newaetech/phywhispererusb/firmware/README.md

# Firmware for SAM3U #

This directory includes the firmware for the SAM3U used as part of the USB interface.

To build, run `make` in `phywhisperer` subdirectory of this firmware directory. You will need the gcc-arm-none-eabi installed for your system (Linux, Windows, etc).
