newaetech/phywhispererusb/hardware/doc/phywhisperer_00.jpg

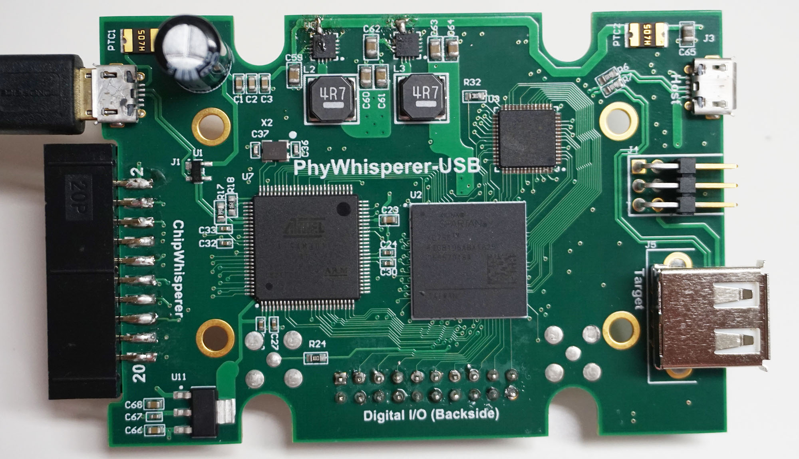
hardware/doc/phywhisperer_00.jpg
