newaetech/phywhispererusb/hardware/doc/phywhisperer_03_back.jpg

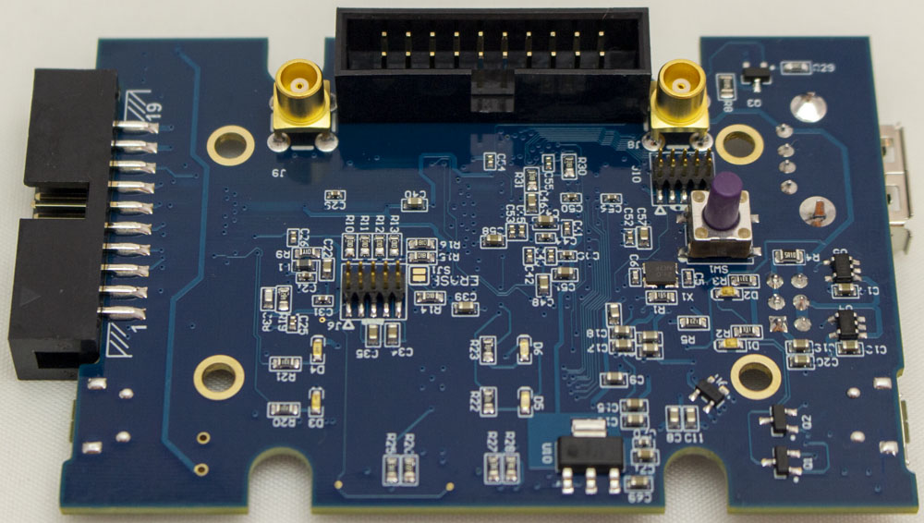
hardware/doc/phywhisperer_03_back.jpg
