newaetech/phywhispererusb/hardware/doc/phywhispererpcb.png

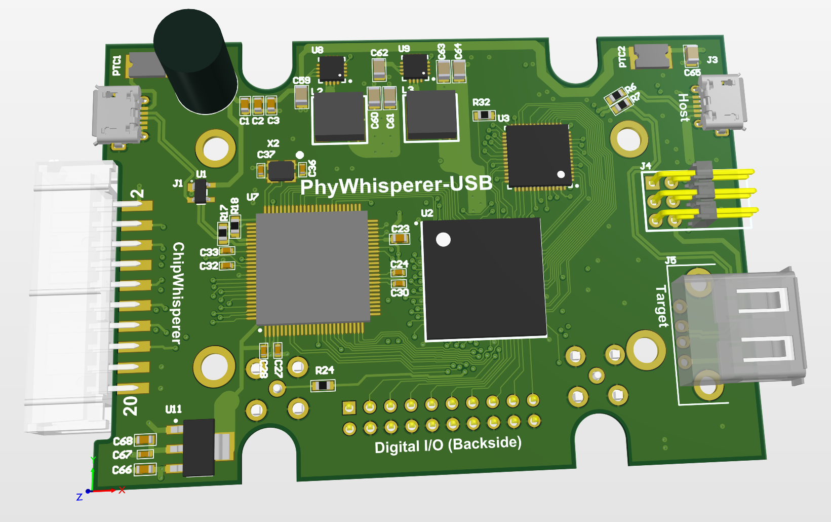
hardware/doc/phywhispererpcb.png
