newaetech/phywhispererusb/hardware/altium_source/altium_fpga_pins.csv

# Altium Pin Report File
Pin Designator | Net Name | Display Name | IO Bank | IO Standard | Slew Rate | Drive Strength | IO Pin | Vref Pin | CLK Pin | Config Pin | Special Pin | Group | Differential Pair
A1 | GND | GND
A2 | LED_CAP | IO_L3N_T0_DQS_34
A3 | USB_NCS | IO_L2N_T0_34
A4 | USB_SPARE1 | IO_L2P_T0_34
A5 | USB_D1 | IO_L4N_T0_34
A6 | GND | GND
A7 | FPGA_TCK | TCK_0
A8 | FPGA_CCLK | CCLK_0
A9 | GND | GND
A10 | F_USB21 | IO_L3N_T0_DQS_EMCCLK_14
A11 | GND | GND
A12 | F_USB29 | IO_L4P_T0_D04_14
A13 | F_USB31 | IO_L4N_T0_D05_14
A14 | GND | GND
B1 | FPGA_CWIO11 | IO_L5N_T0_34
B2 | USB_NWE | IO_L5P_T0_34
B3 | USB_NRD | IO_L3P_T0_DQS_34
B4 | GND | GND
B5 | USB_D5 | IO_L4P_T0_34
B6 | USB_D0 | IO_0_34
B7 | GND | GND
B8 |  | NC
B9 | GND | GND
B10 | F_USB22 | IO_L3P_T0_DQS_PUDC_B_14
B11 | F_USB28 | IO_L1P_T0_D00_MOSI_14
B12 | FPGA_CDOUT | IO_L1N_T0_D01_DIN_14
B13 | F_USB32 | IO_L5P_T0_D06_14
B14 | F_USB0 | IO_L5N_T0_D07_14
C1 | FPGA_CWIO5 | IO_L11N_T1_SRCC_34
C2 | GND | GND
C3 |  | IO_L1N_T0_34
C4 |  | IO_L6N_T0_VREF_34
C5 |  | IO_L6P_T0_34
C6 | GND | GND
C7 | GND | GND
C8 | GND | GND
C9 | GND | GND
C10 | F_USB23 | IO_L2N_T0_D03_14
C11 | F_USB25 | IO_L6P_T0_FCS_B_14
C12 | F_USB30 | IO_L6N_T0_D08_VREF_14
C13 | GND | GND
C14 | F_USB2 | IO_L11N_T1_SRCC_14
D1 | USB_CLK | IO_L11P_T1_SRCC_34
D2 | LED_TRIG | IO_L10N_T1_34
D3 |  | IO_L1P_T0_34
D4 |  | IO_L7N_T1_34
D5 | GND | GND
D6 | VCCINT | VCCINT
D7 | GND | GND
D8 | VCCINT | VCCINT
D9 | GND | GND
D10 | F_USB24 | IO_L2P_T0_D02_14
D11 | GND | GND
D12 |  | IO_L8P_T1_D11_14
D13 | F_USB3 | IO_L8N_T1_D12_14
D14 | F_USB4 | IO_L11P_T1_SRCC_14
E1 | GND | GND
E2 | FPGA_CWIO10 | IO_L10P_T1_34
E3 | GND | GND
E4 |  | IO_L7P_T1_34
E5 | VCCINT | VCCBRAM
E6 | GND | GND
E7 | VCCINT | VCCINT
E8 | GND | GND
E9 | VCCINT | VCCINT
E10 | GND | GND
E11 | F_USB26 | IO_0_14
E12 |  | IO_L7N_T1_D10_14
E13 | F_USB5 | IO_L10N_T1_D15_14
E14 | GND | GND
F1 | FPGA_CWIO4 | IO_L9N_T1_DQS_34
F2 | FPGA_CWIO9 | IO_L8N_T1_34
F3 | FPGA_CWIO3 | IO_L8P_T1_34
F4 |  | IO_L12N_T1_MRCC_34
F5 | GND | GND
F6 | VCCINT | VCCINT
F7 |  | NC
F8 |  | NC
F9 | GND | GND
F10 | VCC1V8 | VCCAUX
F11 | F_USB27 | IO_L12N_T1_MRCC_14
F12 |  | IO_L7P_T1_D09_14
F13 | F_USB6 | IO_L10P_T1_D14_14
F14 | F_USB1 | IO_L9N_T1_DQS_D13_14
G1 | USB_A2 | IO_L9P_T1_DQS_34
G2 | VCCIO | VCCO_34
G3 | GND | GND
G4 |  | IO_L12P_T1_MRCC_34
G5 | VCCINT | VCCBRAM
G6 | GND | GND
G7 |  | NC
G8 |  | NC
G9 | VCCINT | VCCINT
G10 | GND | GND
G11 | USERIO_CLK | IO_L12P_T1_MRCC_14
G12 | GND | GND
G13 | VCCIO | VCCO_14
G14 | F_USB7 | IO_L9P_T1_DQS_14
H1 | USB_A3 | IO_L14N_T2_SRCC_34
H2 | USB_A4 | IO_L14P_T2_SRCC_34
H3 | USB_D2 | IO_L13N_T2_MRCC_34
H4 |  | IO_L13P_T2_MRCC_34
H5 | GND | GND
H6 | VCCINT | VCCINT
H7 |  | NC
H8 |  | NC
H9 | GND | GND
H10 | VCC1V8 | VCCAUX
H11 |  | IO_L13P_T2_MRCC_14
H12 |  | IO_L13N_T2_MRCC_14
H13 | F_USBFE_CLK | IO_L14P_T2_SRCC_14
H14 | F_USB8 | IO_L14N_T2_SRCC_14
J1 | USB_D3 | IO_L15N_T2_DQS_34
J2 | USB_D4 | IO_L15P_T2_DQS_34
J3 | USB_A7 | IO_L17N_T2_34
J4 |  | IO_L17P_T2_34
J5 | VCCINT | VCCBRAM
J6 | GND | GND
J7 |  | DXN_0
J8 |  | DXP_0
J9 | VCCINT | VCCINT
J10 | GND | GND
J11 |  | IO_L17P_T2_D30_14
J12 | F_USB15 | IO_L17N_T2_D29_14
J13 | F_USB10 | IO_L18P_T2_D28_14
J14 | F_USB9 | IO_L18N_T2_D27_14
K1 | GND | GND
K2 | VCCIO | VCCO_34
K3 | USB_SPARE0 | IO_L16N_T2_34
K4 | F_VBDC | IO_L16P_T2_34
K5 | GND | GND
K6 | VCCINT | VCCINT
K7 | GND | GND
K8 | VCCINT | VCCINT
K9 | GND | GND
K10 | VCC1V8 | VCCAUX
K11 | F_USB17 | IO_L19P_T3_D26_14
K12 | F_USB16 | IO_L19N_T3_D25_VREF_14
K13 | VCCIO | VCCO_14
K14 | GND | GND
L1 | USB_A0 | IO_L18N_T2_34
L2 | USB_A1 | IO_L22N_T3_34
L3 | FPGA_CWIO2 | IO_L22P_T3_34
L4 | GND | GND
L5 |  | IO_25_34
L6 | GND | GND
L7 | FPGA_PGMB | PROGRAM_B_0
L8 | GND | GND
L9 | VCC1V8 | VCCAUX
L10 | GND | GND
L11 | GND | GND
L12 | F_USB20 | IO_L16P_T2_CSI_B_14
L13 | F_USB11 | IO_L16N_T2_D31_14
L14 | F_USB12 | IO_L15N_T2_DQS_DOUT_CSO_B_14
M1 | FPGA_CWIO8 | IO_L18P_T2_34
M2 | FPGA_CWIO1 | IO_L19N_T3_VREF_34
M3 | FPGA_CWIO0 | IO_L19P_T3_34
M4 |  | IO_L23N_T3_34
M5 |  | IO_L23P_T3_34
M6 | FPGA_TMS | TMS_0
M7 | VCCIO | M0_0
M8 | VCCIO | M1_0
M9 | VCCIO | M2_0
M10 | USERIO_D7 | IO_25_14
M11 | F_USB19 | IO_L20P_T3_D24_14
M12 | USERIO_D2 | IO_L20N_T3_D23_14
M13 | FPGA_TRIGOUT | IO_L15P_T2_DQS_RDWR_B_14
M14 | F_USB14 | IO_L21N_T3_DQS_D22_14
N1 | FPGA_CWIO7 | IO_L20N_T3_34
N2 | VCCIO | VCCO_34
N3 | GND | GND
N4 | USB_D7 | IO_L24N_T3_34
N5 | GND | GND
N6 | VCCIO | VCCO_0
N7 | VCCIO | CFGBVS_0
N8 | VCCIO | VCCO_0
N9 | GND | GND
N10 | USERIO_D6 | IO_L23P_T3_D19_14
N11 | USERIO_D4 | IO_L23N_T3_D18_14
N12 | GND | GND
N13 | VCCIO | VCCO_14
N14 | F_USB13 | IO_L21P_T3_DQS_14
P1 | GND | GND
P2 | FPGA_CWIO6 | IO_L20P_T3_34
P3 | USB_A5 | IO_L21N_T3_DQS_34
P4 | USB_A6 | IO_L21P_T3_DQS_34
P5 | USB_D6 | IO_L24P_T3_34
P6 | FPGA_TDO | TDO_0
P7 | FPGA_TDI | TDI_0
P8 | FPGA_INITB | INIT_B_0
P9 | FPGA_DONE | DONE_0
P10 | USERIO_D5 | IO_L24P_T3_D17_14
P11 | USERIO_D3 | IO_L24N_T3_D16_14
P12 | USERIO_D1 | IO_L22P_T3_D21_14
P13 | USERIO_D0 | IO_L22N_T3_D20_14
P14 | GND | GND
