newaetech/phywhispererusb/docs/getting-started.rst

.. _getting_started:

########
Overview
########

Todo
