newaetech/phywhispererusb/(threads)

Thread 1 (2019-07-25):

Firmware - Change usb PID

colinoflynn, 2019-07-25:
Actual PID is 0xC610 to be used in future. Will build Windows signed drivers for that as well, once drivers available can switch firmware+python code.

colinoflynn, 2019-11-12:
Fixed in recent commit.

Closed 2019-11-12.

Thread 3 (2020-01-09):

Trigger do not work on custom database descriptor packets

h0rac, 2020-01-09:
Hi

I have following issue with phywhisperer, I am not able to trigger on `dev.ctrl_transfer(bmRequestType=0x80, bRequest=0x06, wValue=0x0001, wIndex=0x0000, data_or_wLength=0x1F, timeout=5)`

My trigger is set to   ` phy.set_pattern(pattern=[0x80, 0x06, 0x00, 0x01, 0x00, 0x00, 0x1F])`

I can trigger on any original packets received on USB bus by phywisperer but not on packets I want to inject using pyusb

When I inject packet I can see it with logic analyser Saleae, but cannot trigger on it using phywisperer

My physical setup: HOST/CONTROL PC connected to OS X, TARGET to USB key

```
try:
    phy = pw.Usb()
    phy.con(program_fpga=True)
    print(phy.get_fpga_buildtime())
    phy.load_bitstream("phywhisperer_top.bit")
    phy.set_usb_mode('auto')
    phy.set_pattern(pattern=[0x80, 0x06, 0x00, 0x01, 0x00, 0x00, 0x1F])
    phy.set_capture_size(8000)
    while True:
        phy.set_power_source("host")
        # time.sleep(0.5)
        dev = usb.core.find(idVendor=2414, idProduct=2132)
        dev.set_configuration()
        if dev is None:
            raise ValueError('Our device is not connected')
        # print("USB Dev:", dev)
        phy.set_trigger(num_triggers=1, delays=[453], widths=[80], enable=True)
        phy.arm()
        dev.ctrl_transfer(bmRequestType=0x80, bRequest=0x06, wValue=0x0001, wIndex=0x0000, data_or_wLength=0x1F, timeout=15)
        time.sleep(0.5)
        phy.set_power_source("off")
        time.sleep(0.1)
        # arm:
        phy.set_power_source("host")
        time.sleep(0.1)
        # phy.wait_disarmed()
        print("done")
        phy.addpattern = True
.....
```

jpcrypt, 2020-01-09:
What does `phy.get_usb_mode()` return? (if it's "auto" then the target speed hasn't been detected properly, which means that the phy won't be programmed correctly).

It's also possible that things get out of whack because you're possibly re-arming PW in the while loop without having captured anything. If you must have a while loop around the PW arming, you should call `reset_fpga()` before re-arming (you'll also need to re-program all PW parameters).

Finally I would try relaxing the match pattern to see what PW *is* seeing.

h0rac, 2020-01-09:
Hi thanks for answer

`phy.get_usb_mode() ` return auto and then FS if I check in loop. When I set it to FS manually it triggers but only for short pattern like [0x00, 0x1F] entire packet trigger is not working.

jpcrypt, 2020-01-09:
Can you try the following:
```
phy = pw.Usb()
phy.con(program_fpga=True)
print(phy.get_fpga_buildtime())
phy.reset_fpga()
phy.set_usb_mode('FS')
#phy.set_pattern(pattern=[0x80, 0x06, 0x00, 0x01, 0x00, 0x00, 0x1F])
phy.set_pattern(pattern=[0x80, 0x06])
phy.set_capture_size(8000)

phy.set_power_source("host")
# time.sleep(0.5)
dev = usb.core.find(idVendor=2414, idProduct=2132)
dev.set_configuration()
if dev is None:
    raise ValueError('Our device is not connected')

phy.arm()
# make sure we haven't seen a match yet:
assert phy.armed() == True

dev.ctrl_transfer(bmRequestType=0x80, bRequest=0x06, wValue=0x0001, wIndex=0x0000, data_or_wLength=0x1F, timeout=15)
phy.wait_disarmed()
print("done")
phy.addpattern = True
raw = phy.read_capture_data()
...
```

Assuming this runs through, look for your pattern in `raw`.

h0rac, 2020-01-09:
it do not trigger, but this one works.. up to [0x00,0x00,0xFF,0xFF]

```
try:
    phy = pw.Usb()
    phy.con()
    phy.set_usb_mode('FS')
    phy.set_pattern(pattern=[0xFF, 0xFF])
    phy.set_capture_size(8000)
    while True:
        phy.set_power_source("host")
        time.sleep(0.25)
        dev = usb.core.find(idVendor=2414, idProduct=2132)
        dev.set_configuration()
        if dev is None:
            dev = usb.core.find(idVendor=2414, idProduct=2132)
            dev.set_configuration()
        # print("USB Dev:", dev)
        # print(ret)
        phy.set_trigger(num_triggers=2, delays=[0,453], widths=[80, 80], enable=True)
        phy.arm()
        resp = dev.ctrl_transfer(bmRequestType=0x80, bRequest=0x06, wValue=0x0001, wIndex=0x0000, data_or_wLength=0xFFFF, timeout=15)
        print(list(resp))
        phy.set_power_source("off")
        # time.sleep(0.1)
        # arm:
        phy.set_power_source("host")
        # time.sleep(0.1)
        phy.wait_disarmed()
        print("done")
        phy.addpattern = True
        raw = phy.read_capture_data()
        # if(phy.armed() == False):
```

jpcrypt, 2020-01-12:
Just an update, I haven't been able to set up a target with pyusb yet to investigate this further; I will try to do that sometime next week.
However I did check that I have no trouble with matching on a similar pattern -- in my case, `[0x80, 0x06, 0x01, 0x03, 0x09, 0x04, 0xFF]`.
So I still suspect that the issue doesn't lie with the PW pattern matching logic. FYI, we verified random patterns and masks up to 64 bytes long in [simulation](https://github.com/newaetech/phywhispererusb/tree/master/hardware/fpga/sim).

h0rac, 2020-01-12:
That was my mistake pattern should be `[0x80, 0x06, 0x00, 0x01, 0x00, 0x00, 0x1F]` instead `[0x80, 0x06, 0x00, 0x01, 0x00, 0x00, 0x1F]`

jpcrypt, 2020-01-12:
Ah, so do you mean that it works and the issue can be closed?

h0rac, 2020-01-14:
Looks like, whatever pyusb sends its reversed in pattern

colinoflynn, 2020-01-14:
Is this a documentation issue? I mean it sounds like this is due to byte/bit ordering that USB uses being not an obvious mapping.

Did the PW-USB feedback show you the correct byte order? Just trying to figure out what all to document! I'm thinking at minimum we could make a small helper macro/function that maps from a USB request to the expected pattern over-the-wire (which would be a very very common usage)

h0rac, 2020-01-14:
This is what I want to test also on other stacks, on OS X it is weird that I can't set using pyusb Device/index as 0x0100/0x00 it simply do not send that correctly. What pyusb is doing is bit shift index | << 8 descriptor_type.  The only request I can send as valid is

`dev.ctrl_transfer(bmRequestType=0x80, bRequest=0x06, wValue=0x0101, wIndex=0x0000, data_or_wLength=0xFFFF)`

Then on phywhisperer I need to catch as pattern
`phy.set_pattern(pattern=[0x80,0x06,0x01,0x01,0x00,0x00,0xFF,0xFF])`

colinoflynn, 2020-01-14:
The byte/bit ordering of USB is LSB first - so when it sends the 16-bit values, they go over the wire as 0x34, x012. This is the "unexpected" part since most people are used to MSB first! Having a helper function would make it more clear how the mapping works.

On the device/index - basically you are limited by the USB stack to sending only "Valid" things. The other trying to try is the wLength value. I've seen that on some stacks you can set it to 0xFFFF, on other stacks it gets limited (0x0400 is  maximum I've seen on a few). It seems to be something added at some point in libusb, so you just get USB errors.

It's worth considering making a dedicated "usb host". GreatFET can basically be used as this too (Facedancer is basically designed for this). But I've also just used a raspberry pi that you can compile your specific version of libusb on...

h0rac, 2020-01-14:
Which version you compiled for Raspberry Pi ? nice hint. I am above on real project testing some USB dongle. I see I can get up to 71 bytes back when glitching and using OS X as. host but.. I also see bunch of errors on Saleae when triggering on crafted packet

colinoflynn, 2020-01-14:
So I'm not positive on control PC - I always did that from regular laptop. In theory (?) it should work but I never tried, so might be some problem with libusb on r-pi. I was using older verions of everything (older kernel).

I actually ended up just dedicating a computer to serve as my control instead (old laptop), so I didn't spend long on the r-pi idea! But In theory it would be nicer/smaller/easier to use r-pi. The laptop was something older - I was playing with Ubuntu 14 & a Windows 7 with an old (~Python 2.7) install.

If you try to send a wLength of 0xFFFF and it gives an error, but the packet does work with a wLength of something smaller (0x00FF) then you know the host is giving you the problem. The end device will ignore a larger wLength, so if you get an error with a wLength of 0xFFFF that means that you'll never get it working I think.

Sorry I don't have exact versions! But if you try a few VMs or something it should be helpful? I ended up doing bare metal as was concerned that the VM-->Host interface would also be giving me trouble. In the end I did get the 0xFFFF to work however - when I get a chance I'll try it on a few systems around to see if any "just work"

h0rac, 2020-01-14:
You end up using Linux bare metal or Windows ?

Thread 4 (2020-01-14):

Problem to use phywhispererusb on Windows 7x64 VM

h0rac, 2020-01-14:
```
>>> import phywhisperer.usb as pw

>>> phy = pw.Usb()

>>> phy.con()
Traceback (most recent call last):
  File "C:\Users\IEUser\WinPython\WPy64-3760\python-3.7.6.amd64\lib\site-package
s\phywhisperer-0.1.0-py3.7.egg\phywhisperer\interface\naeusb.py", line 293, in t
xrx
    self.cmdWriteBulk(payload)
  File "C:\Users\IEUser\WinPython\WPy64-3760\python-3.7.6.amd64\lib\site-package
s\phywhisperer-0.1.0-py3.7.egg\phywhisperer\interface\naeusb.py", line 489, in c
mdWriteBulk
    self.usbdev().write(self.wep, data, timeout=self._timeout)
  File "C:\Users\IEUser\WinPython\WPy64-3760\python-3.7.6.amd64\lib\site-package
s\pyusb-1.0.2-py3.7.egg\usb\core.py", line 948, in write
    self.__get_timeout(timeout)
  File "C:\Users\IEUser\WinPython\WPy64-3760\python-3.7.6.amd64\lib\site-package
s\pyusb-1.0.2-py3.7.egg\usb\backend\libusb0.py", line 533, in bulk_write
    data, timeout)
  File "C:\Users\IEUser\WinPython\WPy64-3760\python-3.7.6.amd64\lib\site-package
s\pyusb-1.0.2-py3.7.egg\usb\backend\libusb0.py", line 616, in __write
    timeout
  File "C:\Users\IEUser\WinPython\WPy64-3760\python-3.7.6.amd64\lib\site-package
s\pyusb-1.0.2-py3.7.egg\usb\backend\libusb0.py", line 431, in _check
    raise USBError(errmsg, ret)
usb.core.USBError: [Errno None] b'libusb0-dll:err [_usb_reap_async] reaping requ
est failed, win error: A device attached to the system is not functioning.\r\n\n
'
Traceback (most recent call last):
  File "<stdin>", line 1, in <module>
  File "C:\Users\IEUser\WinPython\WPy64-3760\python-3.7.6.amd64\lib\site-package
s\phywhisperer-0.1.0-py3.7.egg\phywhisperer\usb.py", line 118, in con
    self._llint.FPGAProgram(bitstream)
  File "C:\Users\IEUser\WinPython\WPy64-3760\python-3.7.6.amd64\lib\site-package
s\phywhisperer-0.1.0-py3.7.egg\phywhisperer\interface\program_fpga.py", line 82,
 in FPGAProgram
    self._FPGADownloadBitstream(bitstream)
  File "C:\Users\IEUser\WinPython\WPy64-3760\python-3.7.6.amd64\lib\site-package
s\phywhisperer-0.1.0-py3.7.egg\phywhisperer\interface\program_fpga.py", line 159
, in _FPGADownloadBitstream
    self._usb.writeBulkEP(buffer_[i])
  File "C:\Users\IEUser\WinPython\WPy64-3760\python-3.7.6.amd64\lib\site-package
s\phywhisperer-0.1.0-py3.7.egg\phywhisperer\interface\naeusb.py", line 634, in w
riteBulkEP
    return self.usbseralizer.writeBulk(data)
  File "C:\Users\IEUser\WinPython\WPy64-3760\python-3.7.6.amd64\lib\site-package
s\phywhisperer-0.1.0-py3.7.egg\phywhisperer\interface\naeusb.py", line 215, in w
riteBulk
    return self.process_rx(self.txrx(tx=cmdpacket))
  File "C:\Users\IEUser\WinPython\WPy64-3760\python-3.7.6.amd64\lib\site-package
s\phywhisperer-0.1.0-py3.7.egg\phywhisperer\interface\naeusb.py", line 145, in p
rocess_rx
    raise payload
usb.core.USBError: [Errno None] None

[Errno None] None

```

I got this error on Windows VM when trying to connect to PhyWhisperer, on OS X/LInux it works fine. However I would like to use WinUSB stack to send GET descriptor with 0xFFFF length

Device is correctly installed using drivers from repository directly. I used FAQ and steps on Windows section of Prerequisites

colinoflynn, 2020-01-14:
What does it show up as in device manager? I think we've used it on a Win7 x64 system so it should work...

h0rac, 2020-01-14:
Hi Colin, it is enumerated and shows as

PhyWhisperer-USB CW610

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

jpcrypt, 2021-01-06:
I don't have a Win7 to test with but possibly the changes to use WinUSB fixes this: https://github.com/newaetech/phywhispererusb/commit/c1a385c1718a19a87273cd16f6077d73284f9835
Re-open if it's still a problem.

Closed 2021-01-06.

Thread 5 (2020-01-24):

USB power switches short the power supply when disabled

duckythescientist, 2020-01-24:
The AP22802 USB power switch chip shorts the output to ground (through ~90ohms) when the output is disabled. This makes sense when they are used to just switch a device on and off, but since the Phywhisperer has the the output of two switches connected together, when one is on, the other one shorts the output to ground.

I noticed this after our board would no longer power the target device. Troubleshooting shows that the two AP22802's are fried.

colinoflynn, 2020-01-24:
Damn - so AP2171AW-7 doesn't have the drain feature and would solve the problem. If you can email sales@newae.com so can figure out RMA on your unit (or if you can fix there, spare parts cost etc).

In theory the heating should be:

5V/90ohm = 0.28W. @ 157C/W from datasheet for SOT25 package, means internal device temp would be 45C above ambient. Still way below max junction temp even with some additional heating due to enclosure (say even if 50C in enclosure).

Will do more testing here - never saw a problem running them for many hours. A quick finger check doesn't seem to have much heating, thermal camera wasn't working (normal part of check) but will try to get back online or borrow one asap to confirm.

Was it being used any way that would add additional draw? The AP22802 are also EOL suddenly, so I might see if there was some errata/fix they pushed into the new device (AP22811, which still has discharge so will change device on stock here & future runs).

duckythescientist, 2020-01-25:
The team was using it a lot with a Pi Zero that was being externally powered. However, the AP22802 has reverse current protection, so I'm not exactly sure if or how the backpowering could worsen the situation. And I agree with you on thermals that they should get toasty but not disastrously so.

We bought a handful of replacement AP22802's, so once those come in, I may swap those in and check the behavior. I'm curious how accurate the 90ohm figure is. I also modified the cable for the Pi Zero by cutting V+ so that backpowering won't be an issue.

AP2171AW-7 could be an ok replacement, but it can only switch half the current of the AP22802.

(A personal note: I've been mostly on a different project, but I will hopefully be back full time on the team using the Phywhisperer in about a week and a half. I'm limited on what debugging/experimentation I can do until that transition, but the rest of the team is picking up some of this in the meantime.)

colinoflynn, 2020-01-26:
Responding mobile so just short note:

AP2191 would have more current capability. Honestly I only thought of
people using it with standard USB 2 devices (< 500ma) for the most part so
didn't consider current handling limiting too closely...

I had checked the 90 ohm seems accurate. Measuring current into the sniffer
port showed constant 51 mA with no load, matches expected closely.

Will try some backpower tests too though, could be something there! Thanks
for details!

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

colinoflynn, 2021-02-24:
We've since switched the parts around on units shipped out for the past year - I'm going to close this now. We also confirmed it's too low for it to heat up in practice - so old ones sitting out there should be fine, but in case anyone runs across it we'll of course RMA the units in the future!

Closed 2021-02-24.

Thread 14 (2021-10-17):

Missing firmware upgrade instructions

cyrozap, 2021-10-17:
I'd like to update the firmware of my PhyWhisperer-USB, but I can't find a list of steps to do that. I can see there's an `auto_program()` function in the API, but there aren't any usage examples (e.g., do I need to do some other initialization beforehand?) and it's unclear that programming the device with "default firmware" will update it to the latest version.

jpcrypt, 2024-03-21:
Sorry for ignoring this for so long! `auto_program()` is indeed the way to update to the latest version; the documentation has been updated.

Closed 2024-03-21.

Thread 19 (2024-03-03):

continuous realtime sniffing

nitrogar, 2024-03-03:
i search online and through the API documentation and code, but could not figure out how to stream the usb packets directly to the host without queuing them in the FIFO.

the FIFO is small for my use case and I always get :

WARNING:root:FIFO overflowed, capture stopped.
WARNING:root:1878315 entries captured.

so is there a way to just stream the packets directly without storing them or an API to clear the FIFIO periodically

thanks for the great project.

jpcrypt, 2024-03-03:
Unfortunately no. Even in streaming mode, captured data needs to go through the FPGA's FIFO. If the rate of captured data exceeds the transfer rate that we can sustain over the USB link, there is potential for overflow.

colinoflynn, 2024-03-03:
Depending on what you are capturing, if you can change the configuration to reduce the packet flow rate the PhyWhisperer might be able to "keep up" with the host emptying the FIFO in a loop. Nothing inherently prevents you from doing this, just that if the USB traffic is too bursty it will overflow the FIFO.

If you didn't see, there is a [demonstration notebook](https://github.com/newaetech/phywhispererusb/blob/master/software/jupyter/stream.ipynb).

Closed 2024-03-03.
