newaetech/phywhispererusb/hardware/doc/phywhisperer_usb_sch00.PDF

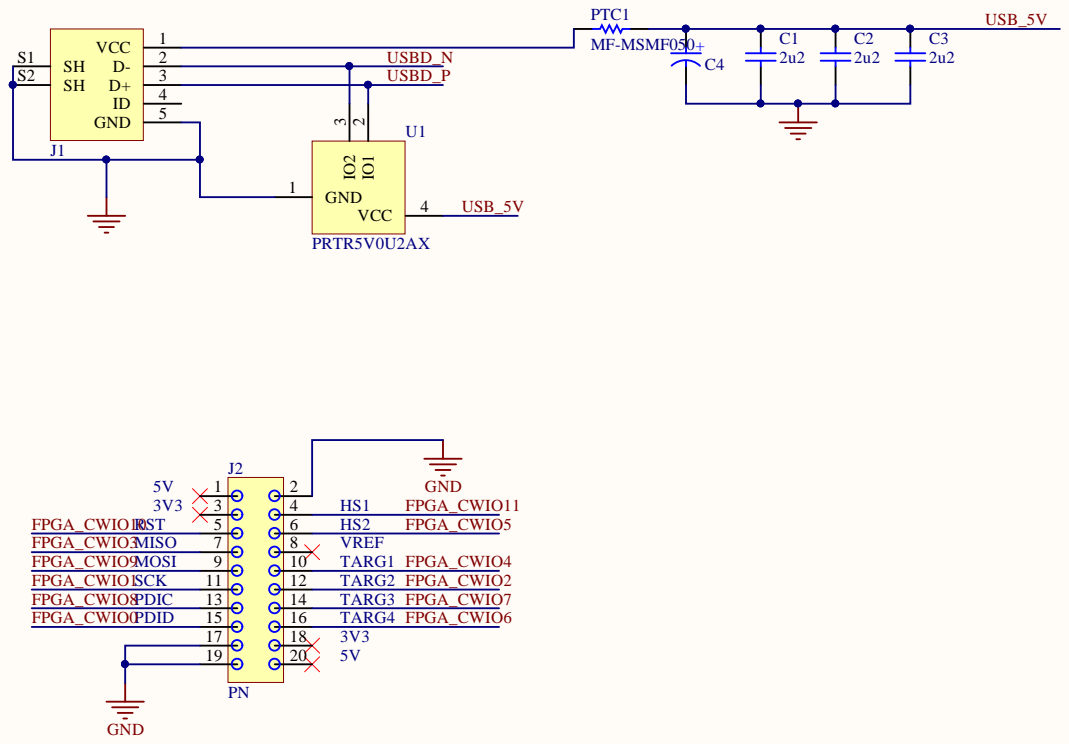
[picture p7: page 1]

Back Panel Title: | Approved: NO

Rev: 00 | Project: PhyWhisperer-USB | License: GPL

Date: 28/03/2019 Time: 9:42:57 PM | Sheet of

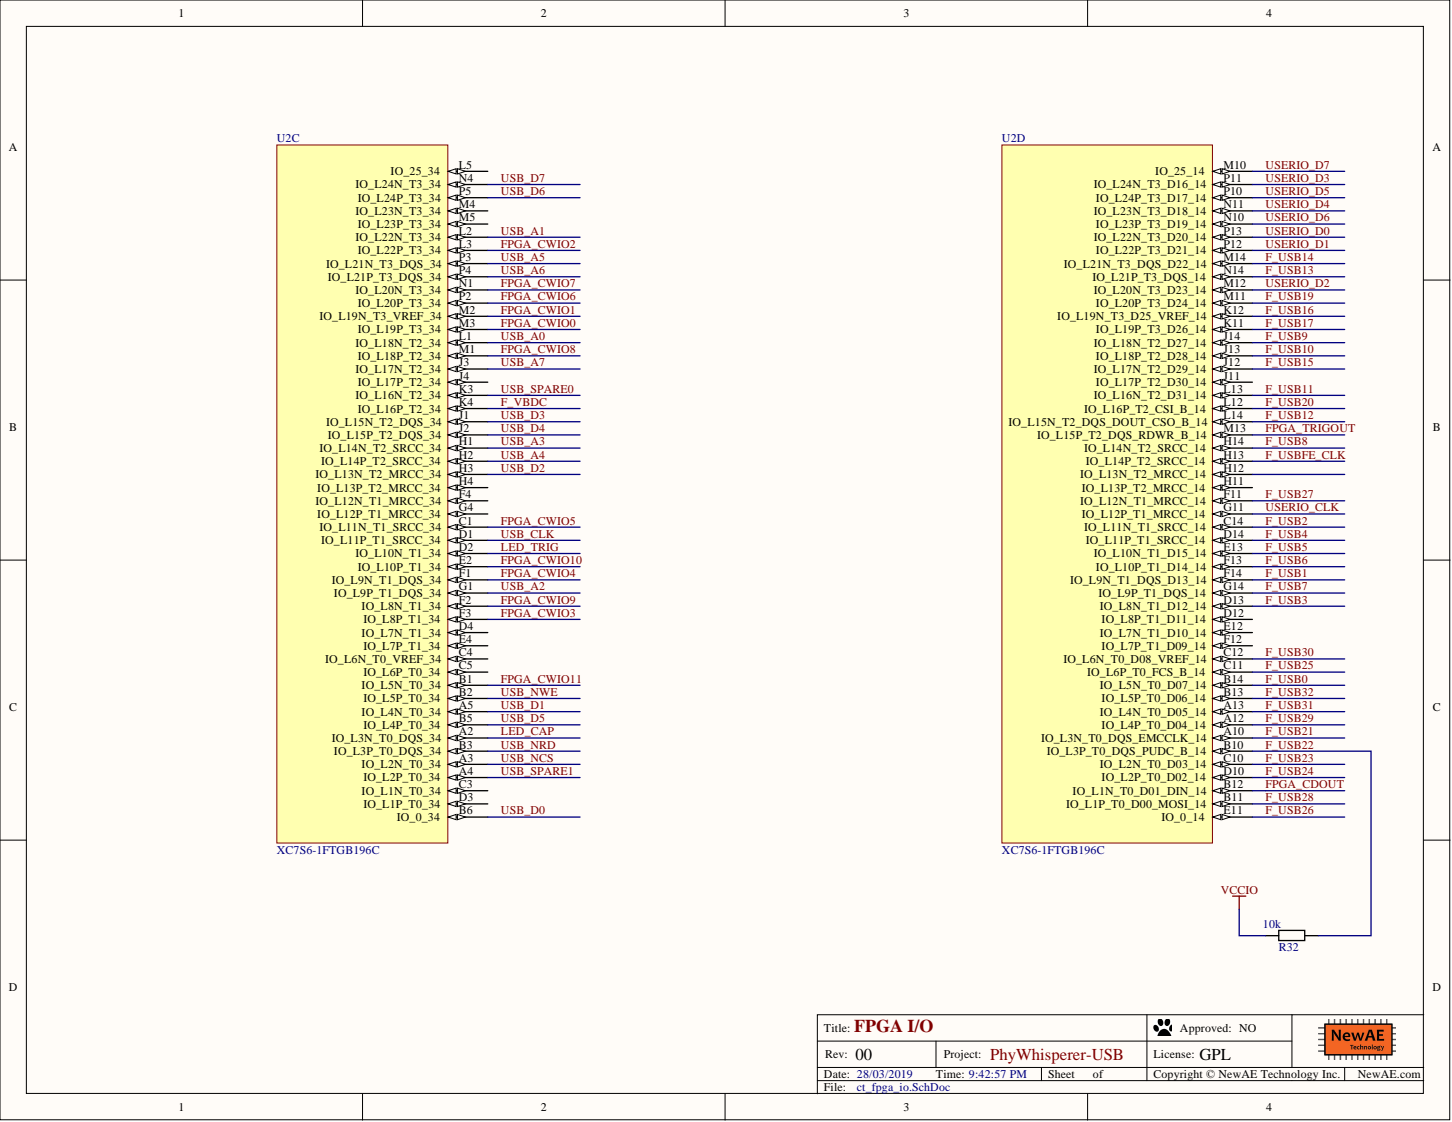
[picture p8: page 2]

T i t le: | A p pro ved : N O

Rev : 00 | Project : PhyWhisperer-USB | L icen se: GPL

T ime: : : 7 PM | Sheet o f | Co p yri g h t © New A E Tech n | o l o g y Inc.

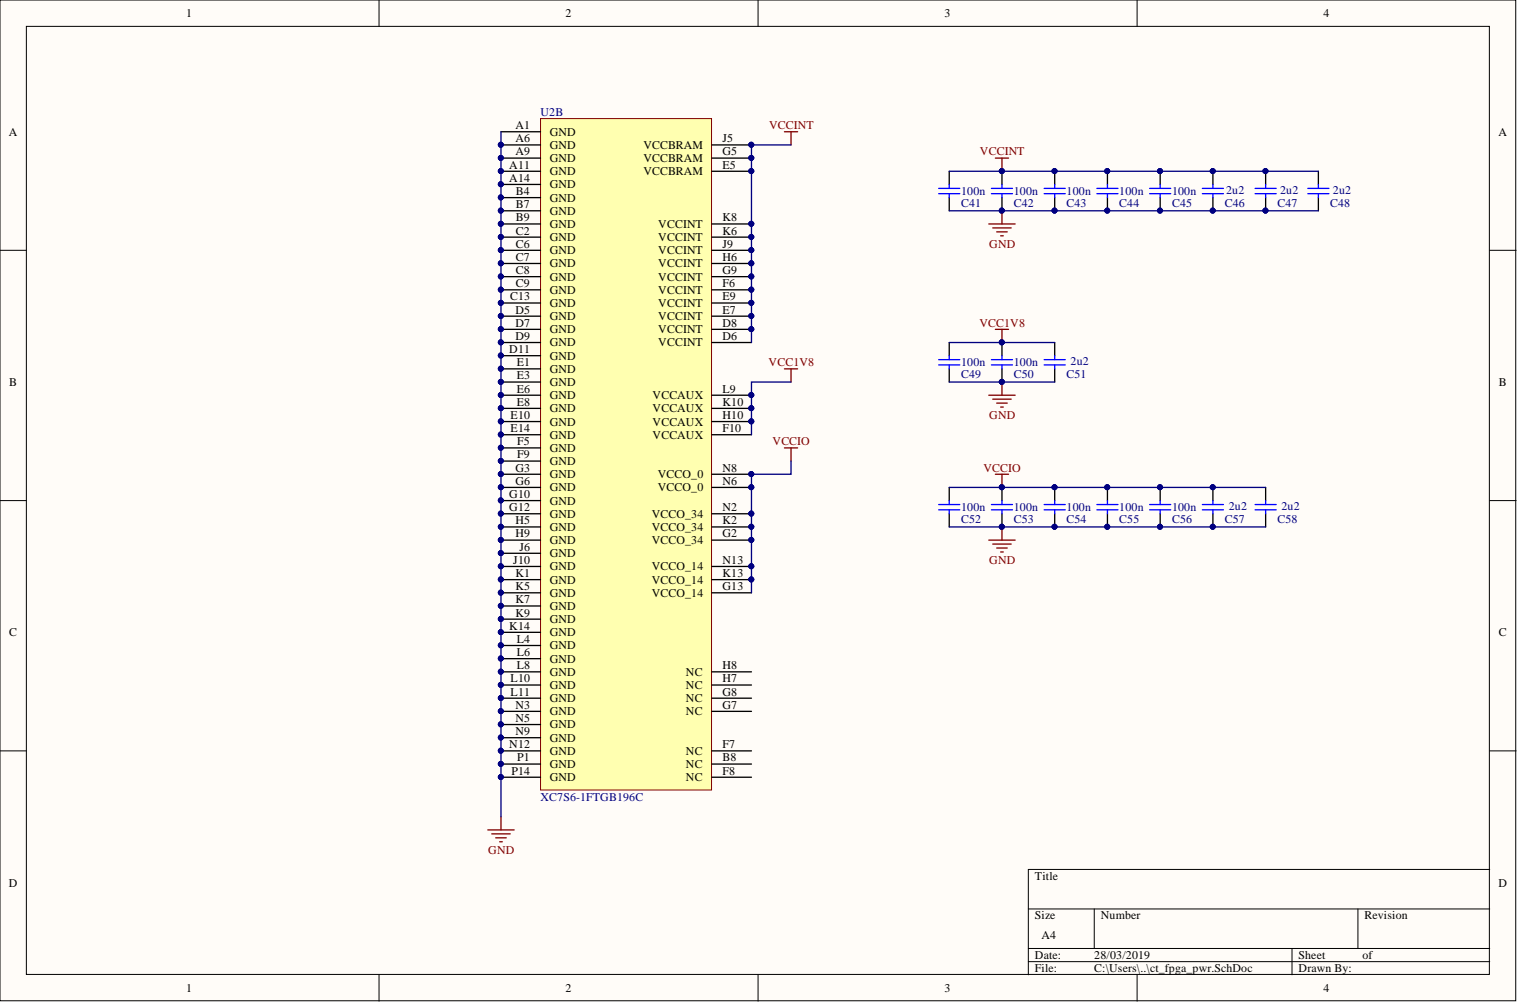
[picture p9: page 3]

A 9 | G 5
A 1 1 | E 5
A 1 4 | K 8

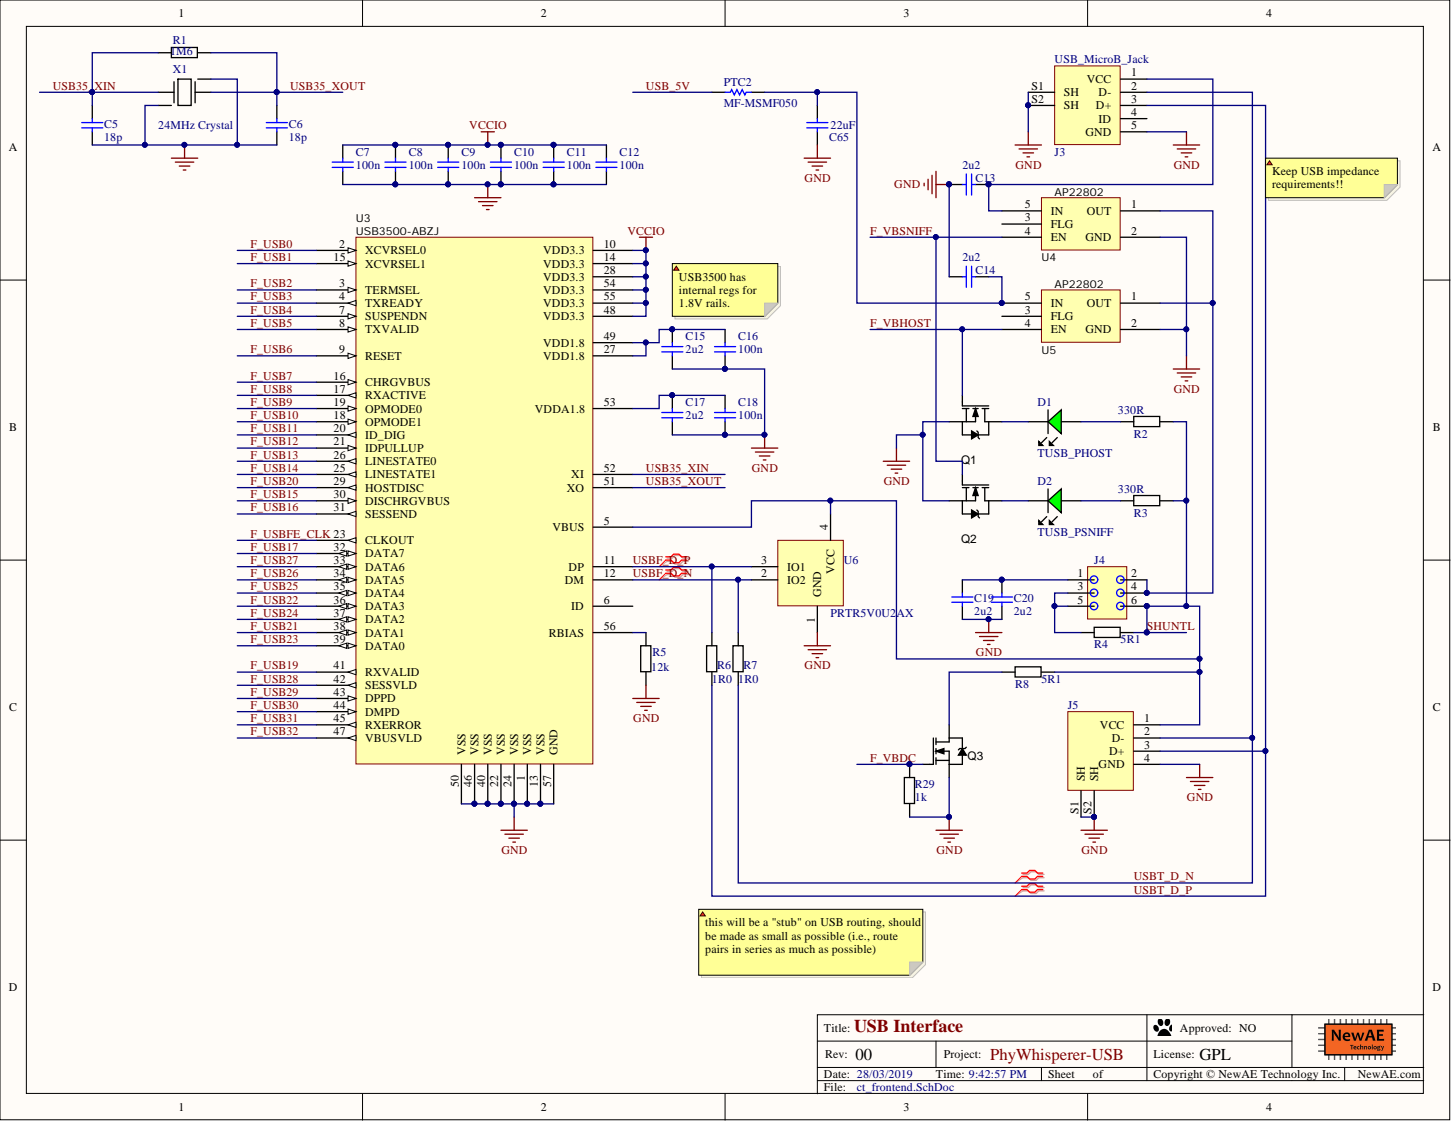
[picture p10: page 4]

T USB_PSNIFF

1 2 USBF_ D _ N | 2

n series as much as p

T i t le: | A p pro ved : N O

Rev : 00 | Project : PhyWhisperer-USB | L icen se: GPL

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

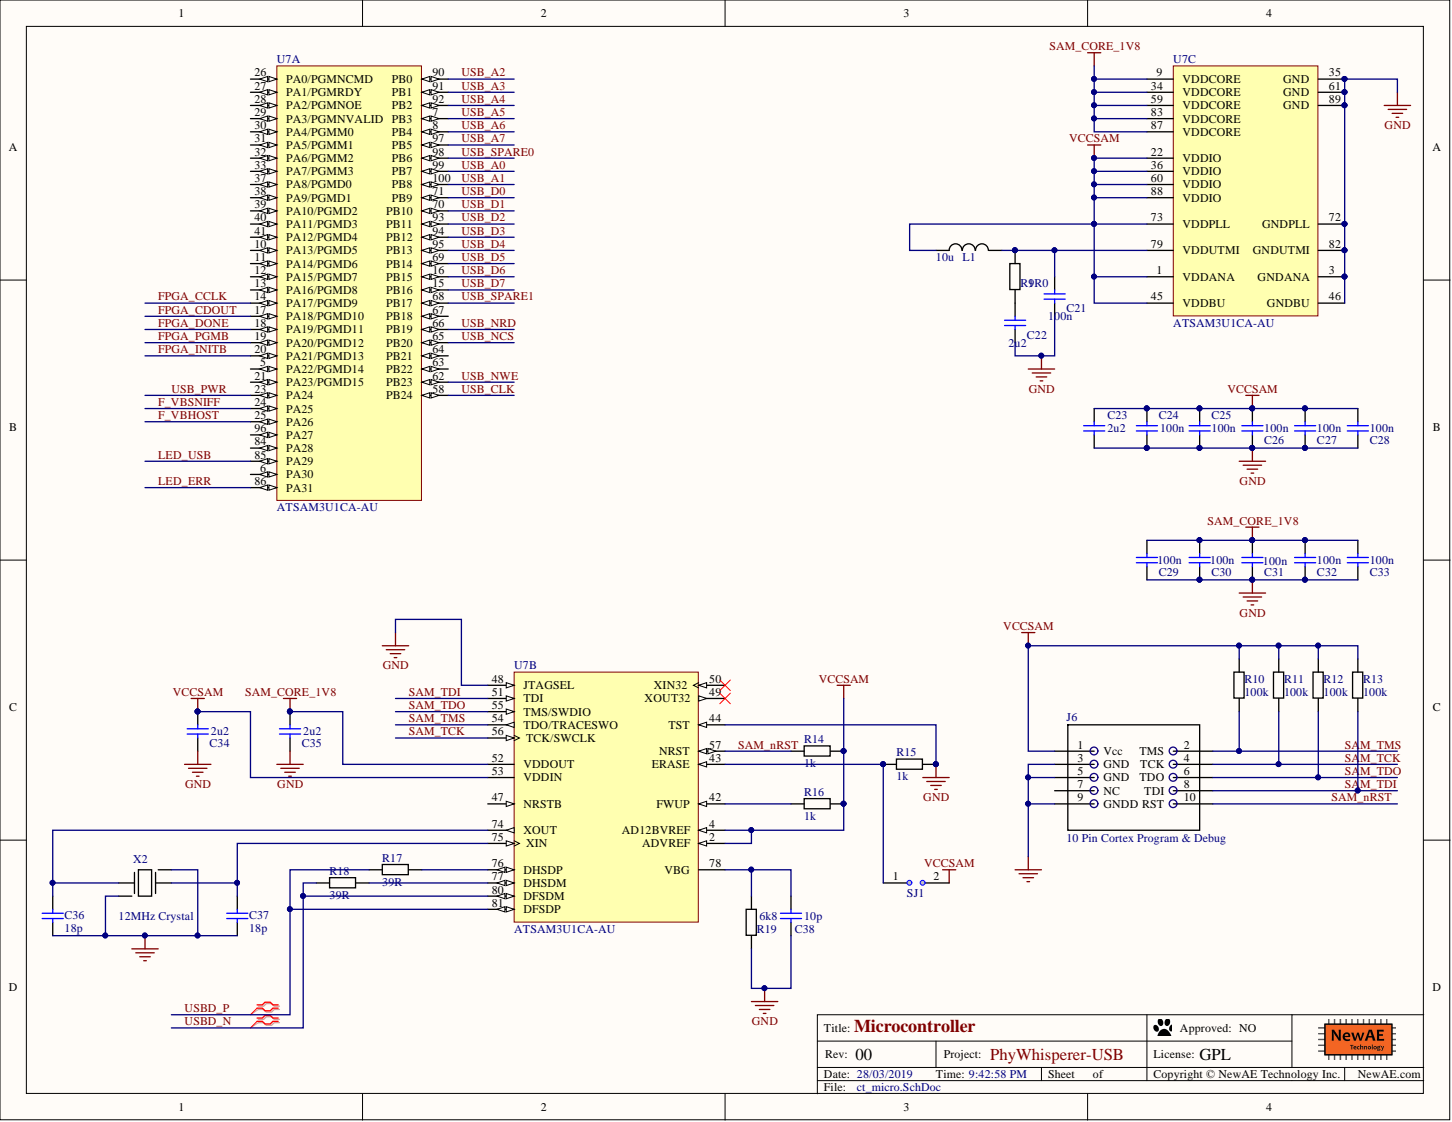
[picture p11: page 5]

XIN 75

10 Pin Cortex Program & Debug

R17 | DHSDP 76

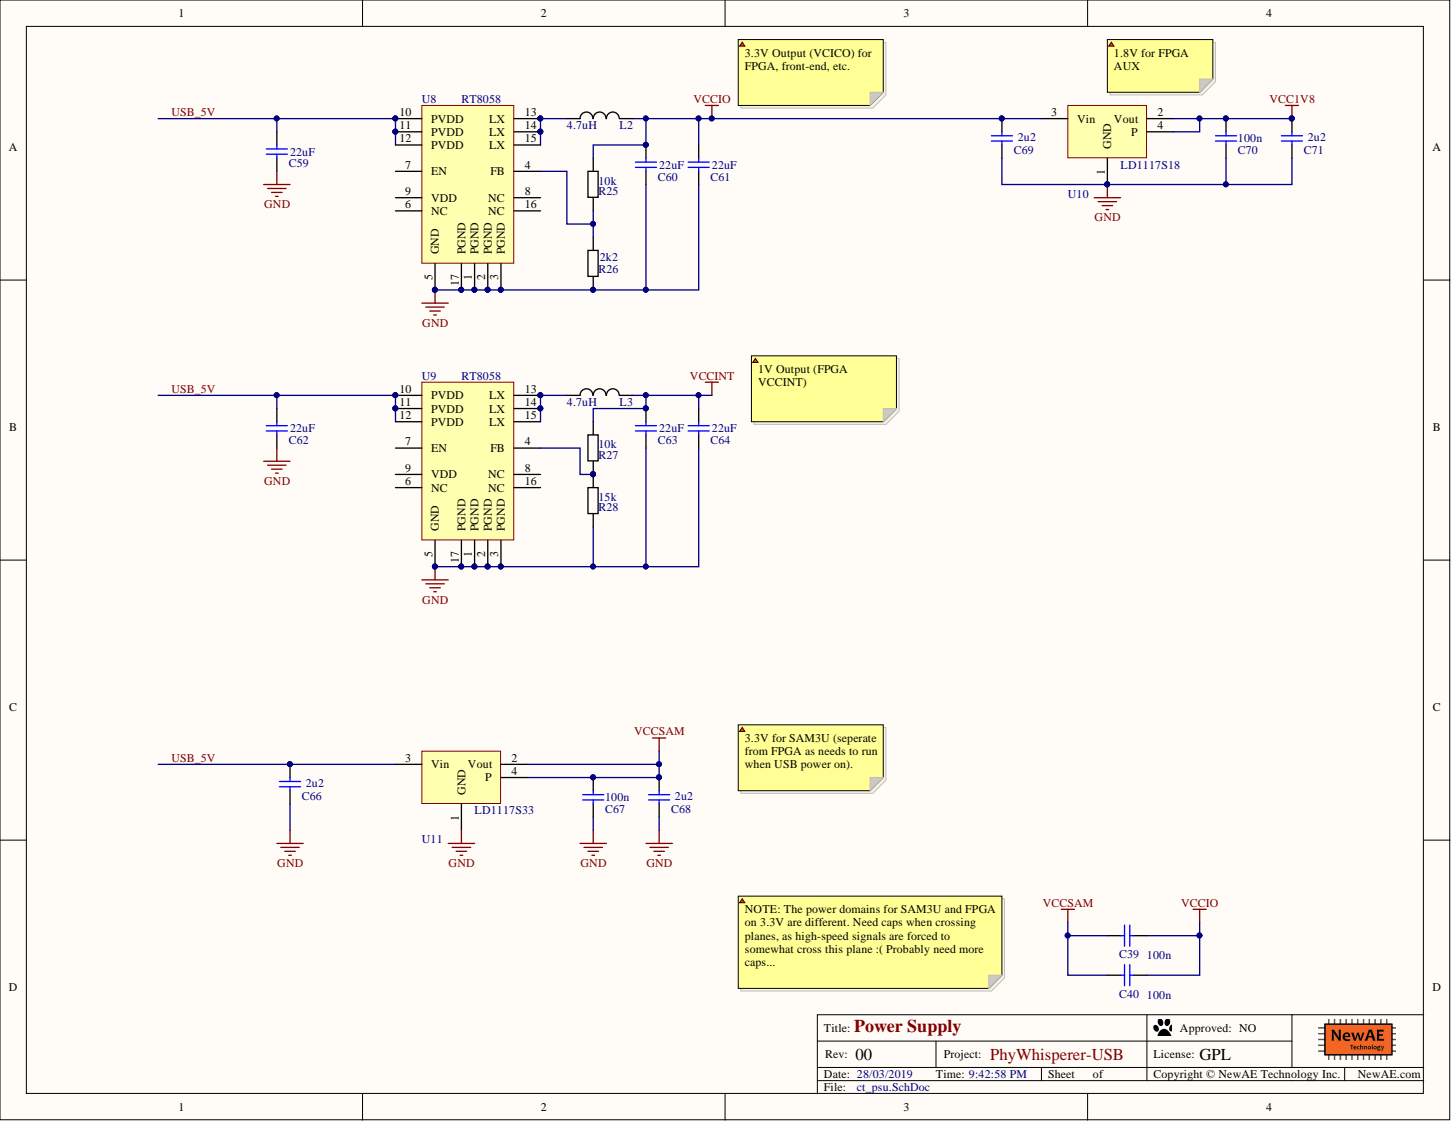
[picture p12: page 6]

3.3V Output (VCICO) for
FPGA, front-end, etc.

3.3V for SAM3U (seperate
from FPGA as needs to run
when USB power on).

NOTE: The power domains for SAM3U and FPGA
on 3.3V are different. Need caps when crossing
planes, as high-speed signals are forced to
somewhat cross this plane :( Probably need more
caps...

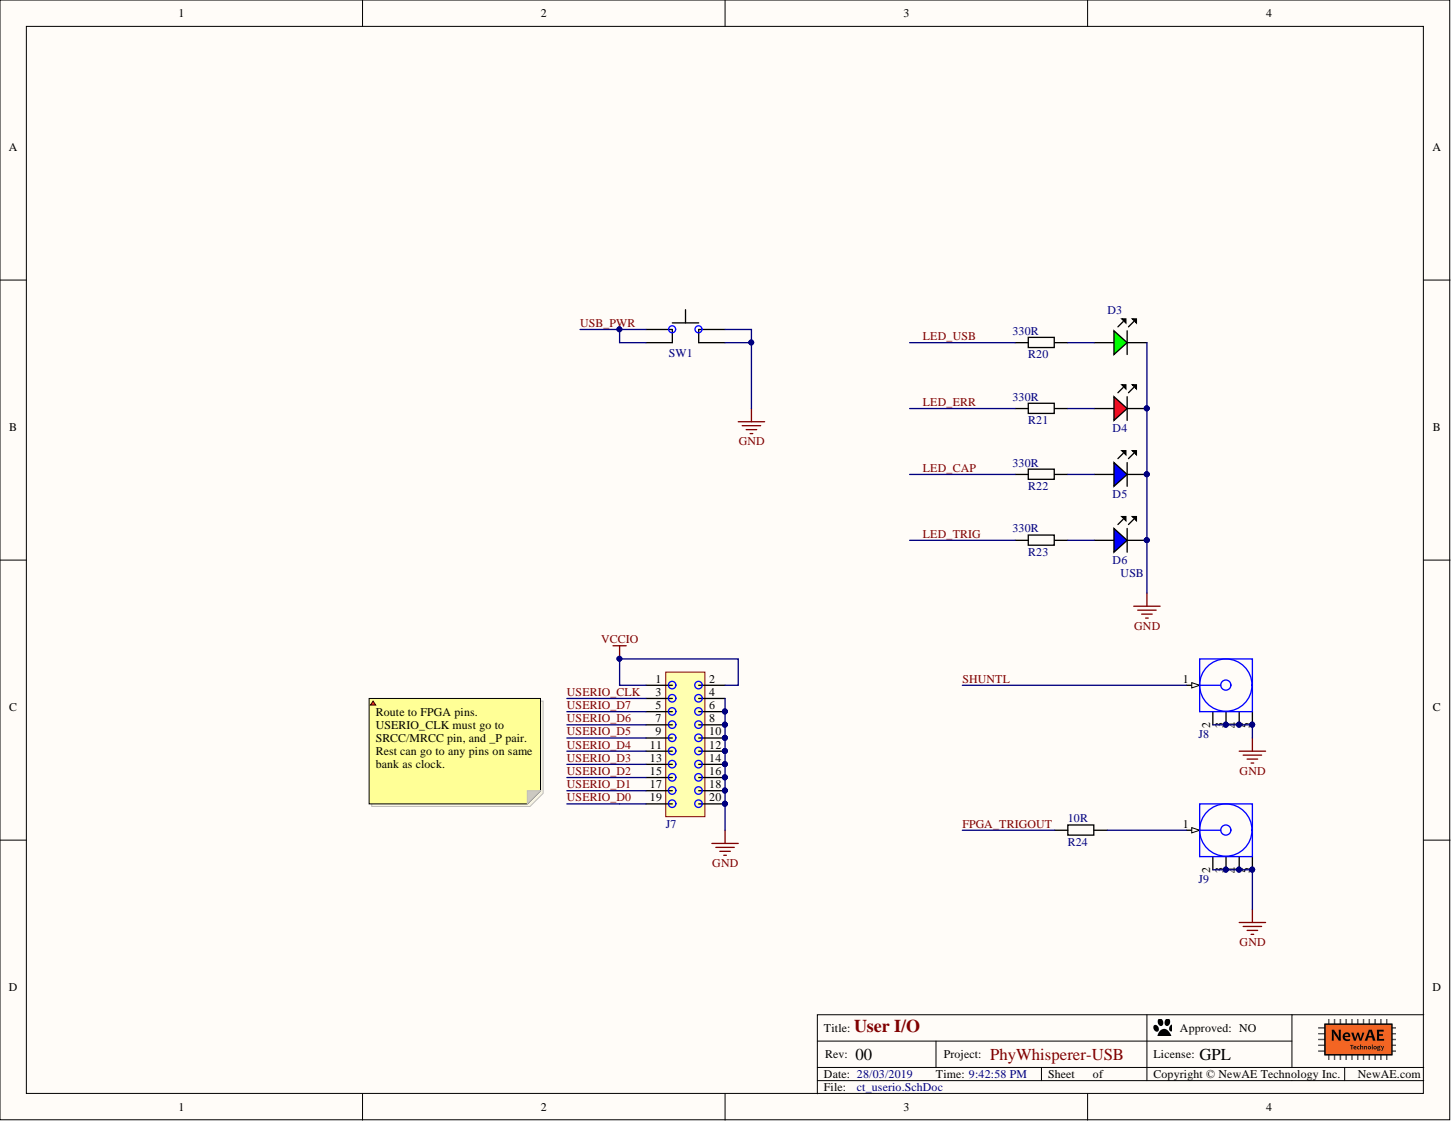
[picture p13: page 7]

Route to FPGA pins.
USERIO_CLK must go to
SRCC/MRCC pin, and _P pair.
Rest can go to any pins on same
bank as clock.

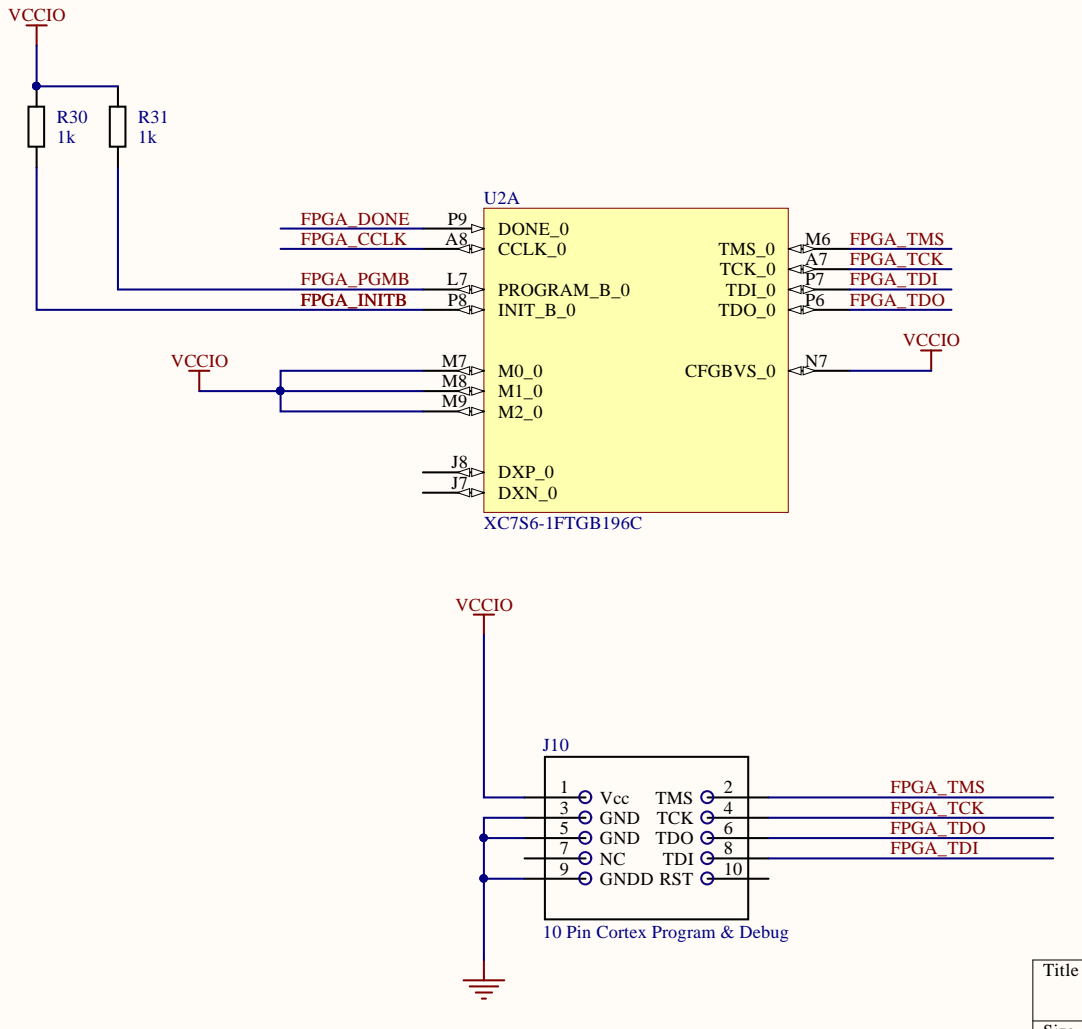
[picture p14: page 8]

10 Pin Cortex Program & Debug
