newaetech/phywhispererusb/hardware/doc/phywhisperer_usb_sch04.PDF

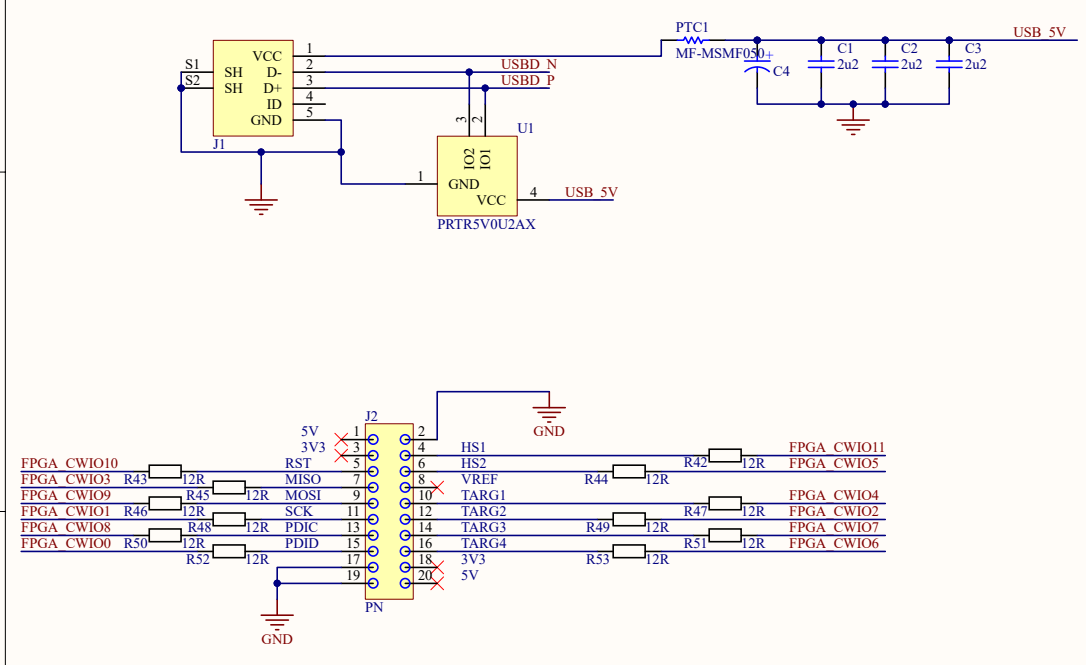
[picture p15: page 1]

IO_0_34 | B6 IO_L1P_T0_34 | D3 IO_L1N_T0_34 | C3 IO_L2P_T0_34 | A4 IO_L2N_T0_34 | A3 IO_L3P_T0_DQS_34 | B3 IO_L3N_T0_DQS_34 | A2 IO_L4P_T0_34 | B5 IO_L4N_T0_34 | A5 IO_L5P_T0_34 | B2 IO_L5N_T0_34 | B1 IO_L6P_T0_34 | C5 IO_L6N_T0_VREF_34 | C4 IO_L7P_T1_34 | E4 IO_L7N_T1_34 | D4 IO_L8P_T1_34 | F3 IO_L8N_T1_34 | F2 IO_L9P_T1_DQS_34 | G1 IO_L9N_T1_DQS_34 | F1 IO_L10P_T1_34 | E2 IO_L10N_T1_34 | D2 IO_L11P_T1_SRCC_34 | D1 IO_L11N_T1_SRCC_34 | C1 IO_L12P_T1_MRCC_34 | G4 IO_L12N_T1_MRCC_34 | F4 IO_L13P_T2_MRCC_34 | H4 IO_L13N_T2_MRCC_34 | H3 IO_L14P_T2_SRCC_34 | H2 IO_L14N_T2_SRCC_34 | H1 IO_L15P_T2_DQS_34 | J2 IO_L15N_T2_DQS_34 | J1 IO_L16P_T2_34 | K4 IO_L16N_T2_34 | K3 IO_L17P_T2_34 | J4 IO_L17N_T2_34 | J3 IO_L18P_T2_34 | M1 IO_L18N_T2_34 | L1 IO_L19P_T3_34 | M3 IO_L19N_T3_VREF_34 | M2 IO_L20P_T3_34 | P2 IO_L20N_T3_34 | N1 IO_L21P_T3_DQS_34 | P4 IO_L21N_T3_DQS_34 | P3 IO_L22P_T3_34 | L3 IO_L22N_T3_34 | L2 IO_L23P_T3_34 | M5 IO_L23N_T3_34 | M4 IO_L24P_T3_34 | P5 IO_L24N_T3_34 | N4 IO_25_34 | L5
IO_0_14 | E11 IO_L1P_T0_D00_MOSI_14 | B11 IO_L1N_T0_D01_DIN_14 | B12 IO_L2P_T0_D02_14 | D10 IO_L2N_T0_D03_14 | C10 IO_L3P_T0_DQS_PUDC_B_14 | B10 IO_L3N_T0_DQS_EMCCLK_14 | A10 IO_L4P_T0_D04_14 | A12 IO_L4N_T0_D05_14 | A13 IO_L5P_T0_D06_14 | B13 IO_L5N_T0_D07_14 | B14 IO_L6P_T0_FCS_B_14 | C11 IO_L6N_T0_D08_VREF_14 | C12 IO_L7P_T1_D09_14 | F12 IO_L7N_T1_D10_14 | E12 IO_L8P_T1_D11_14 | D12 IO_L8N_T1_D12_14 | D13 IO_L9P_T1_DQS_14 | G14 IO_L9N_T1_DQS_D13_14 | F14 IO_L10P_T1_D14_14 | F13 IO_L10N_T1_D15_14 | E13 IO_L11P_T1_SRCC_14 | D14 IO_L11N_T1_SRCC_14 | C14 IO_L12P_T1_MRCC_14 | G11 IO_L12N_T1_MRCC_14 | F11 IO_L13P_T2_MRCC_14 | H11 IO_L13N_T2_MRCC_14 | H12 IO_L14P_T2_SRCC_14 | H13 IO_L14N_T2_SRCC_14 | H14 IO_L15P_T2_DQS_RDWR_B_14 | M13 IO_L15N_T2_DQS_DOUT_CSO_B_14 | L14 IO_L16P_T2_CSI_B_14 | L12 IO_L16N_T2_D31_14 | L13 IO_L17P_T2_D30_14 | J11 IO_L17N_T2_D29_14 | J12 IO_L18P_T2_D28_14 | J13 IO_L18N_T2_D27_14 | J14 IO_L19P_T3_D26_14 | K11 IO_L19N_T3_D25_VREF_14 | K12 IO_L20P_T3_D24_14 | M11 IO_L20N_T3_D23_14 | M12 IO_L21P_T3_DQS_14 | N14 IO_L21N_T3_DQS_D22_14 | M14 IO_L22P_T3_D21_14 | P12 IO_L22N_T3_D20_14 | P13 IO_L23P_T3_D19_14 | N10 IO_L23N_T3_D18_14 | N11 IO_L24P_T3_D17_14 | P10 IO_L24N_T3_D16_14 | P11 IO_25_14 | M10

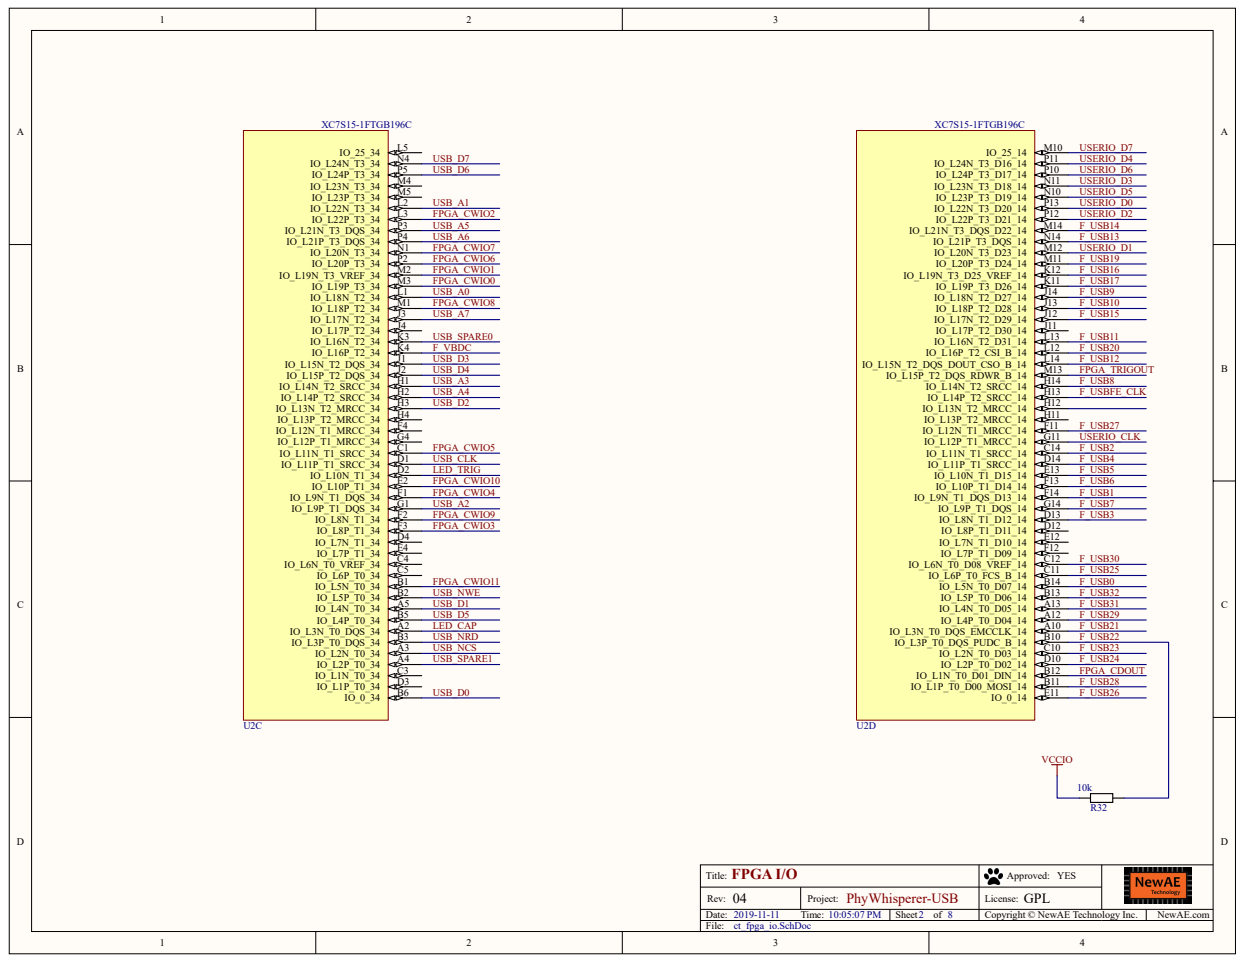
[picture p16: page 2]
FPGA I/O; ct_fpga_io.SchDoc; Title:; Approved: YES; USERIO_CLK; USERIO_D0; USERIO_D1; USERIO_D2; USERIO_D3; USERIO_D4; USERIO_D5; USERIO_D6; USERIO_D7; USB_D1; USB_D2; USB_D3 USB_D4; USB_D5; USB_D6; USB_D7; USB_D0; USB_A2; USB_A3 USB_A4; USB_A5 USB_A6; USB_A7; USB_A0; USB_A1; USB_NWE; USB_NRD USB_NCS; FPGA_CDOUT; FPGA_CWIO0; FPGA_CWIO1; FPGA_CWIO2; FPGA_CWIO3; FPGA_CWIO4; FPGA_CWIO5; FPGA_CWIO6; FPGA_CWIO7; FPGA_CWIO8; FPGA_CWIO9; FPGA_CWIO10; FPGA_CWIO11; F_USB0; F_USB1; F_USB2; F_USB3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

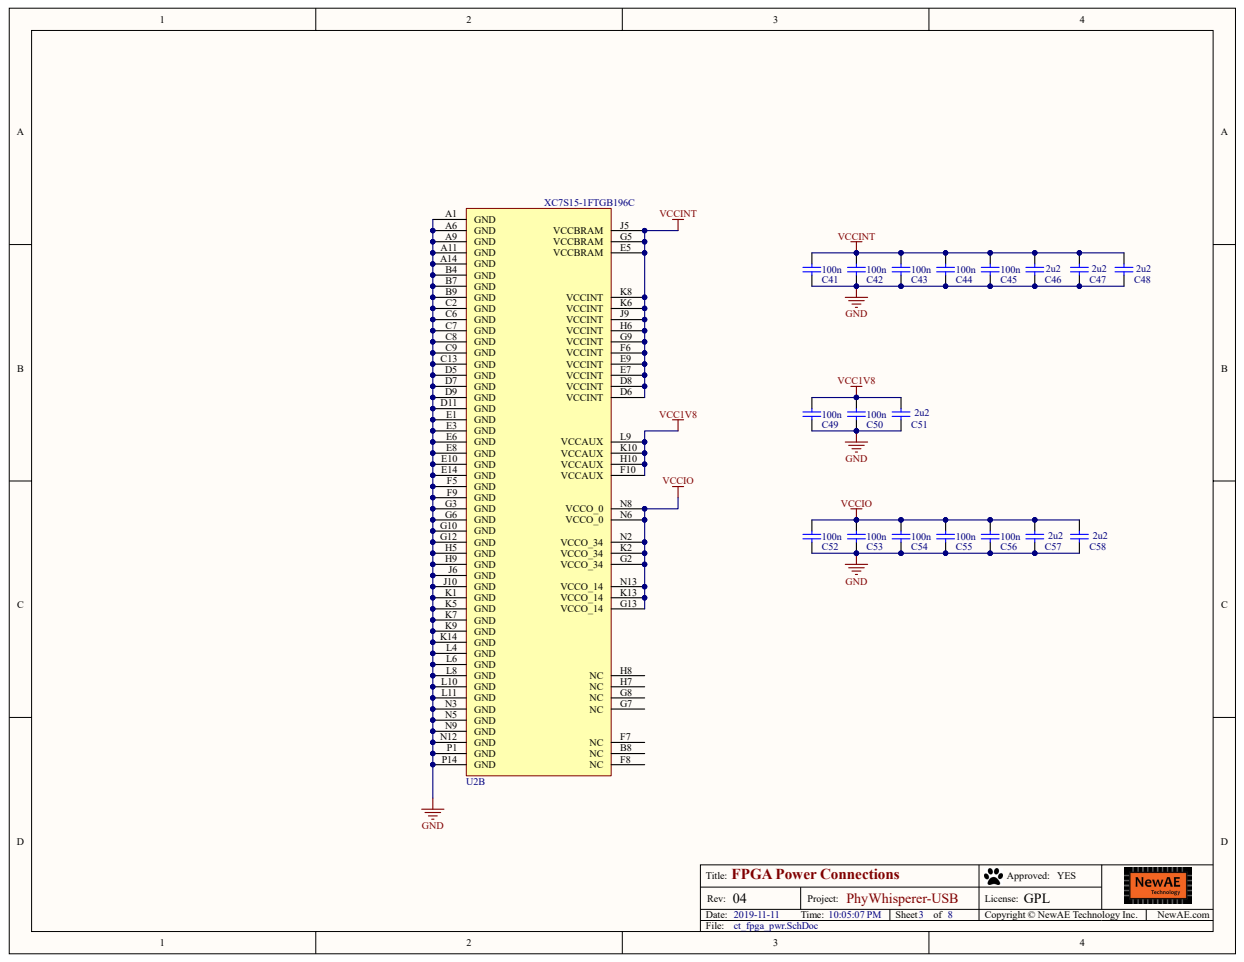
[picture p17: page 3]

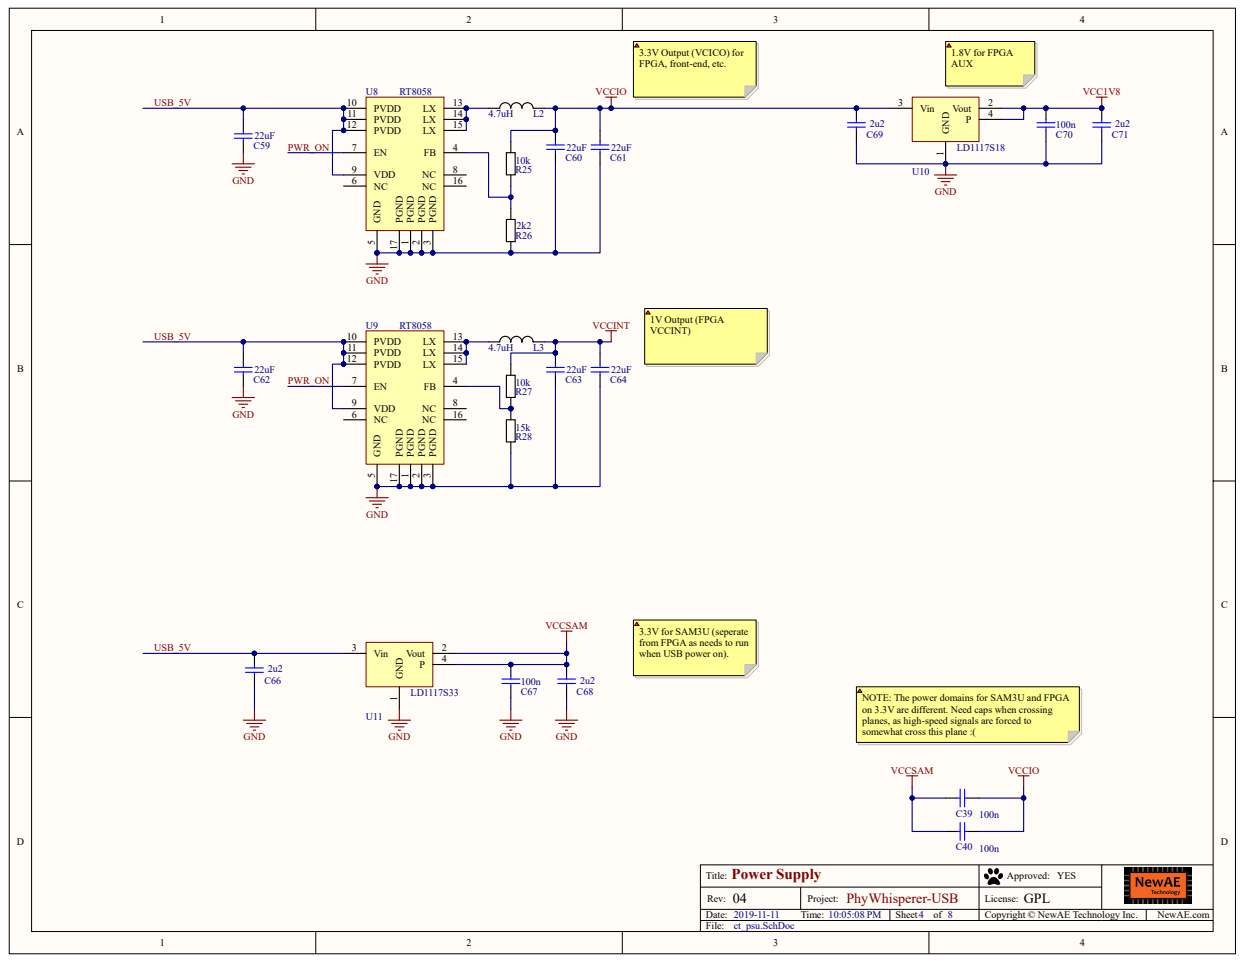
[picture p18: page 4]

3.3V Output (VCICO) for
FPGA, front-end, etc.

3.3V for SAM3U (seperate
from FPGA as needs to run
when USB power on).

NOTE: The power domains for SAM3U and FPGA
on 3.3V are different. Need caps when crossing
planes, as high-speed signals are forced to
somewhat cross this plane :(

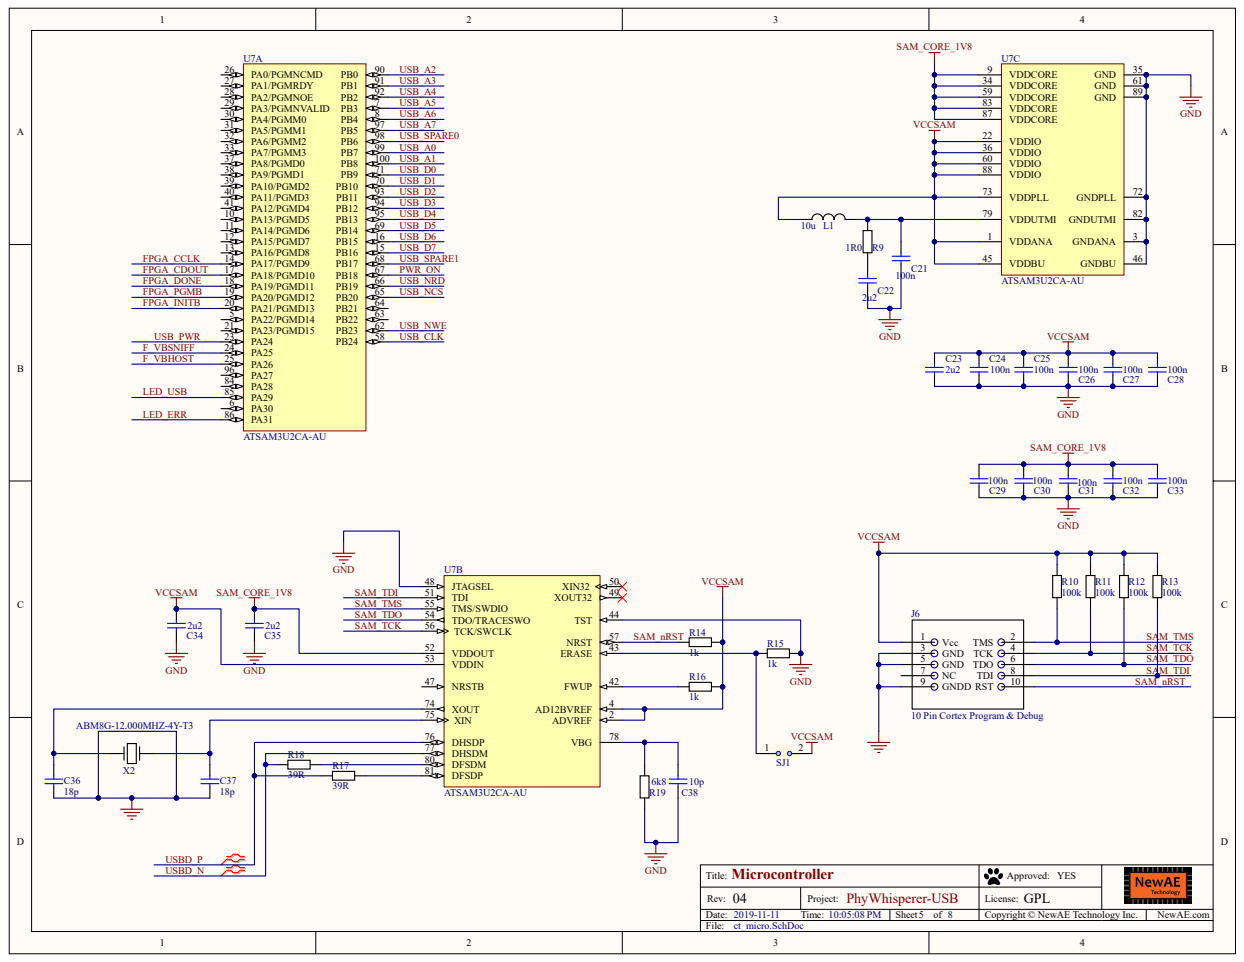
[picture p19: page 5]

10 Pin Cortex Program & Debug

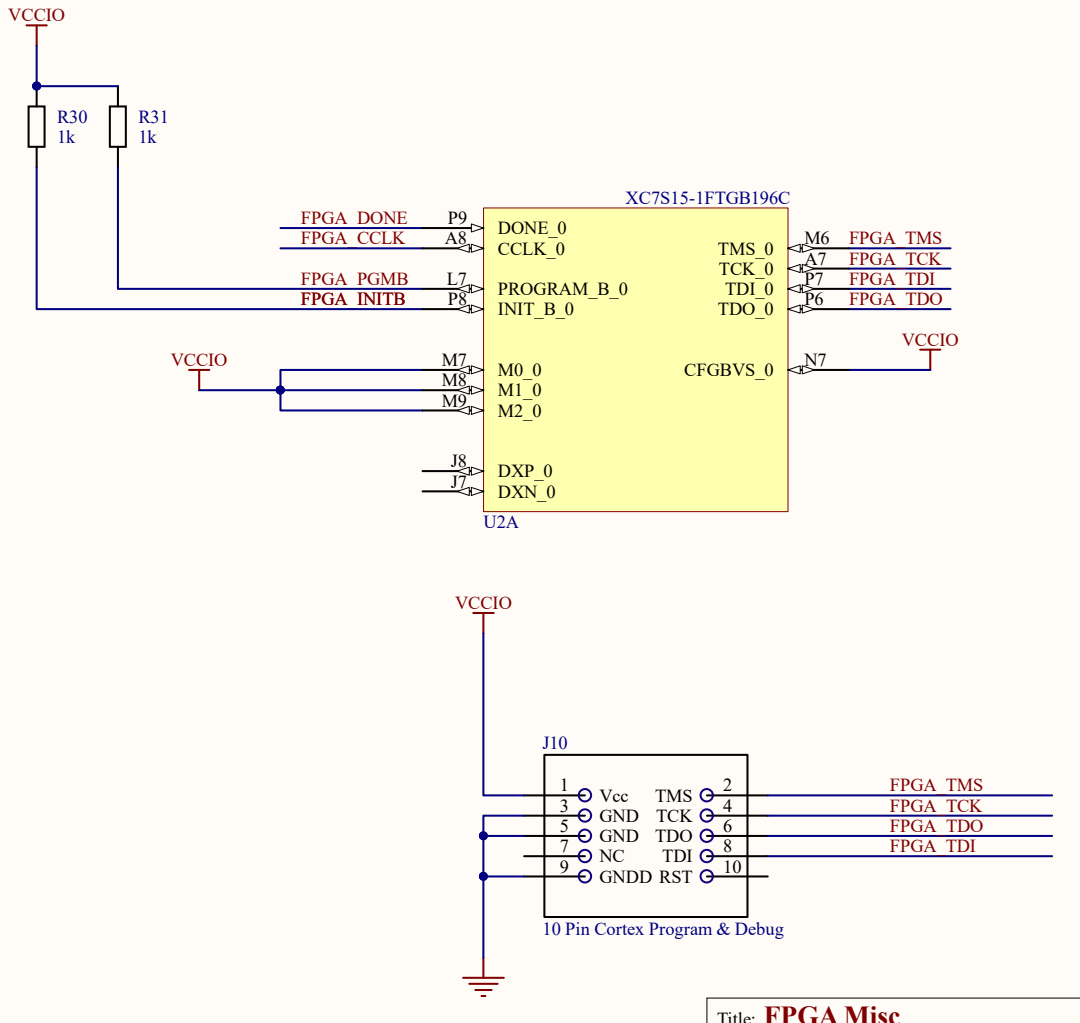
[picture p20: page 6]

10 Pin Cortex Program & Debug

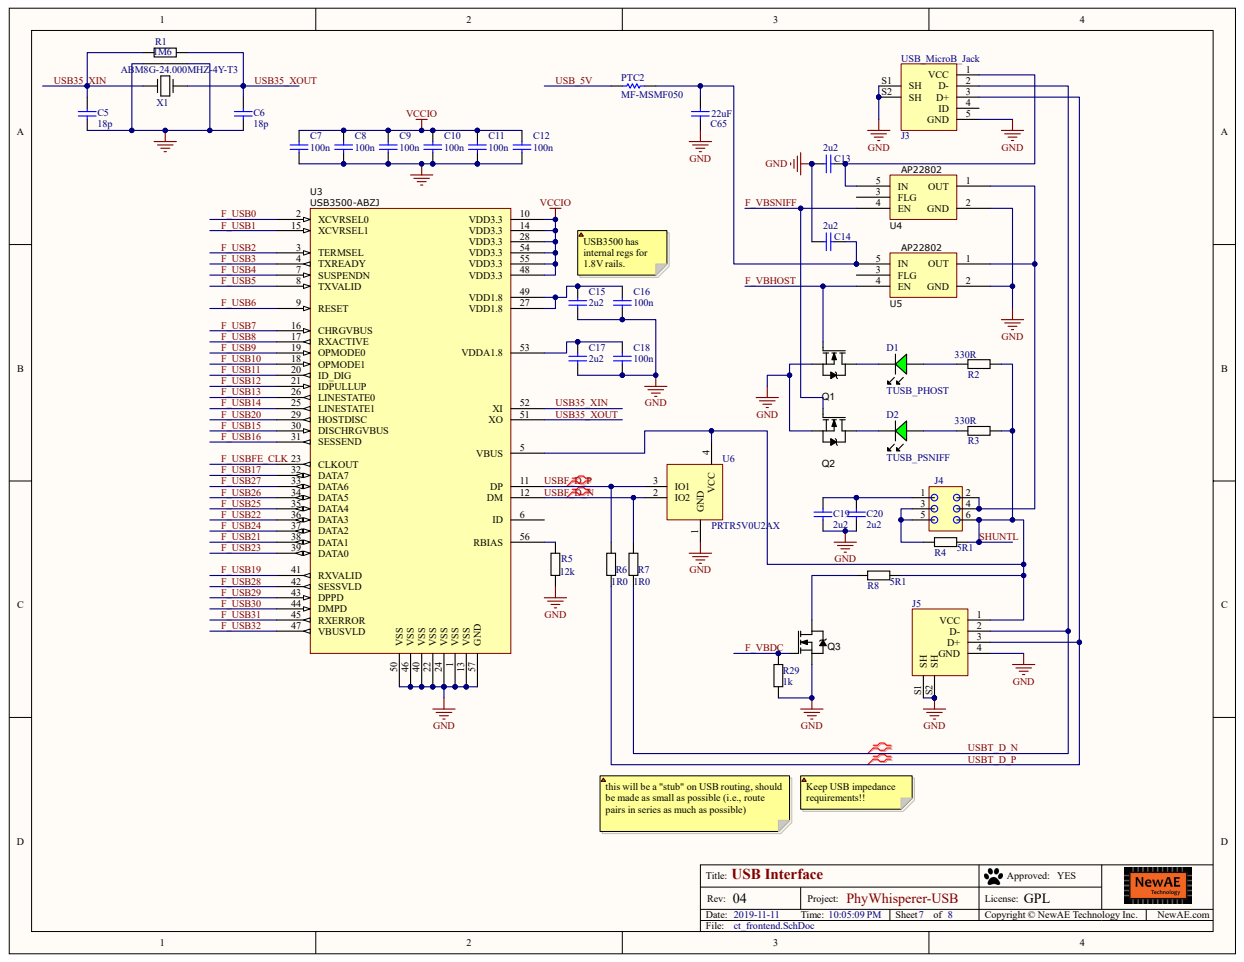
[picture p21: page 7]

this will be a "stub" on USB routing, should
be made as small as possible (i.e., route
pairs in series as much as possible)

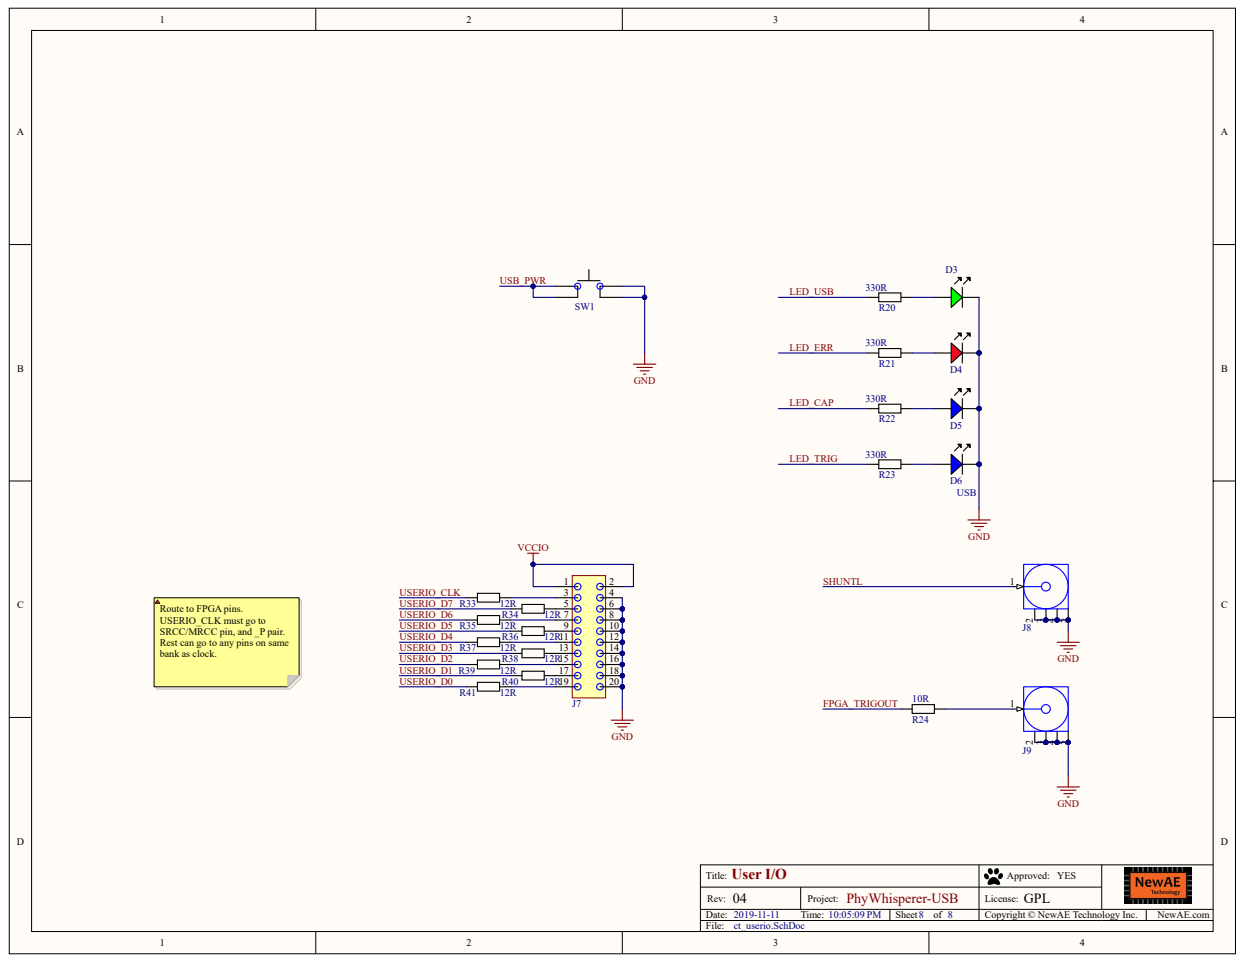
[picture p22: page 8]

Route to FPGA pins.
USERIO_CLK must go to
SRCC/MRCC pin, and _P pair.
Rest can go to any pins on same
bank as clock.
