newaetech/phywhispererusb/(list of files, drawings)

Other design files:
hardware/altium_source/phywhisperer_usb_pcb/ct_back.SchDoc
hardware/altium_source/phywhisperer_usb_pcb/ct_fpga_io.SchDoc
hardware/altium_source/phywhisperer_usb_pcb/ct_fpga_pwr.SchDoc
hardware/altium_source/phywhisperer_usb_pcb/ct_frontend.SchDoc
hardware/altium_source/phywhisperer_usb_pcb/ct_micro.SchDoc
hardware/altium_source/phywhisperer_usb_pcb/ct_psu.SchDoc
hardware/altium_source/phywhisperer_usb_pcb/ct_userio.SchDoc
hardware/altium_source/phywhisperer_usb_pcb/cwtrigger_usb.PrjPcb
hardware/altium_source/phywhisperer_usb_pcb/fpga_misc.SchDoc
