newaetech/phywhispererusb/firmware/hal/sam3u1c/inc/cw521.h

/**
 * \file
 *
 * \brief SAM3U-EK Board Definition.
 *
 * Copyright (c) 2011 - 2013 Atmel Corporation. All rights reserved.
 *
 * \asf_license_start
 *
 * \page License
 *
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
 * 3. The name of Atmel may not be used to endorse or promote products derived
 *    from this software without specific prior written permission.
 *
 * 4. This software may only be redistributed and used in connection with an
 *    Atmel microcontroller product.
 *
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
 * \asf_license_stop
 *
 */

#ifndef _SAM3U_EK_H_
#define _SAM3U_EK_H_

#include "compiler.h"
#include "system_sam3u.h"
#include "exceptions.h"

/*----------------------------------------------------------------------------*/
/**
 *  \page sam3u_ek_opfreq SAM3U-EK - Operating frequencies
 *  This page lists several definition related to the board operating frequency
 *
 *  \section Definitions
 *  - \ref BOARD_FREQ_*
 *  - \ref BOARD_MCK
 */

/** Board oscillator settings */
#define BOARD_FREQ_SLCK_XTAL        (0U)
#define BOARD_FREQ_SLCK_BYPASS      (0U)
#define BOARD_FREQ_MAINCK_XTAL      (12000000U)
#define BOARD_FREQ_MAINCK_BYPASS    (12000000U)

/** Master clock frequency */
#define BOARD_MCK                   CHIP_FREQ_CPU_MAX

/** board main clock xtal startup time */
#define BOARD_OSC_STARTUP_US   15625

/*----------------------------------------------------------------------------*/
/**
 * \page sam3u_ek_board_info SAM3U-EK - Board informations
 * This page lists several definition related to the board description.
 *
 * \section Definitions
 * - \ref BOARD_NAME
 * - \ref sam3uek
 * - \ref sam3u
 * - \ref cortexm3
 */

/** Name of the board */
#define BOARD_NAME "ChipWhisperer-CW521"
/** Board definition */
#define cw521
/** Family definition (already defined) */
#define sam3u
/** Core definition */
#define cortexm3

/*----------------------------------------------------------------------------*/
//! Pins ADC
#define PINS_ADC12B_TRIG  PIO_PA2_IDX
#define PINS_ADC12B_TRIG_FLAG  (PIO_PERIPH_B | PIO_DEFAULT)
#define PINS_ADC_TRIG  PIO_PA17_IDX
#define PINS_ADC_TRIG_FLAG  (PIO_PERIPH_B | PIO_DEFAULT)

//! UART pins (UTXD0 and URXD0) definitions, PA9,10.
#define PINS_UART       (PIO_PA11A_URXD | PIO_PA12A_UTXD)
#define PINS_UART_FLAGS (PIO_PERIPH_A | PIO_DEFAULT)

#define PINS_UART_MASK PIO_PA11A_URXD|PIO_PA12A_UTXD
#define PINS_UART_PIO PIOA
#define PINS_UART_ID ID_PIOA
#define PINS_UART_TYPE PIO_PERIPH_A
#define PINS_UART_ATTR PIO_DEFAULT



/** EBI Data Bus pins */
#define PIN_EBI_DATA_BUS_D0        PIO_PB9_IDX
#define PIN_EBI_DATA_BUS_D1        PIO_PB10_IDX
#define PIN_EBI_DATA_BUS_D2        PIO_PB11_IDX
#define PIN_EBI_DATA_BUS_D3        PIO_PB12_IDX
#define PIN_EBI_DATA_BUS_D4        PIO_PB13_IDX
#define PIN_EBI_DATA_BUS_D5        PIO_PB14_IDX
#define PIN_EBI_DATA_BUS_D6        PIO_PB15_IDX
#define PIN_EBI_DATA_BUS_D7        PIO_PB16_IDX
#define PIN_EBI_DATA_BUS_D8        PIO_PB25_IDX
#define PIN_EBI_DATA_BUS_D9        PIO_PB26_IDX
#define PIN_EBI_DATA_BUS_D10        PIO_PB27_IDX
#define PIN_EBI_DATA_BUS_D11        PIO_PB28_IDX
#define PIN_EBI_DATA_BUS_D12        PIO_PB29_IDX
#define PIN_EBI_DATA_BUS_D13        PIO_PB30_IDX
#define PIN_EBI_DATA_BUS_D14        PIO_PB31_IDX
#define PIN_EBI_DATA_BUS_D15        PIO_PB6_IDX

#define PIN_EBI_DATA_BUS_FLAG1   PIO_PERIPH_A | PIO_PULLUP
#define PIN_EBI_DATA_BUS_FLAG2   PIO_PERIPH_B | PIO_PULLUP

/* NBS0 = A0 = LB# */
/* NBS1      = UB# */
#define PIN_EBI_ADDR_BUS_NBS0 PIO_PB7_IDX
#define PIN_EBI_ADDR_BUS_NBS1 PIO_PC15_IDX

#define PIN_EBI_ADDR_BUS_FLAG1  PIO_PERIPH_B | PIO_PULLUP
#define PIN_EBI_ADDR_BUS_FLAG2  PIO_PERIPH_A | PIO_PULLUP

#define PIN_EBI_ADDR_BUS_A0        PIO_PB7_IDX
#define PIN_EBI_ADDR_BUS_A1        PIO_PB8_IDX
#define PIN_EBI_ADDR_BUS_A2        PIO_PC0_IDX
#define PIN_EBI_ADDR_BUS_A3        PIO_PC1_IDX
#define PIN_EBI_ADDR_BUS_A4        PIO_PC2_IDX
#define PIN_EBI_ADDR_BUS_A5        PIO_PC3_IDX
#define PIN_EBI_ADDR_BUS_A6        PIO_PC4_IDX
#define PIN_EBI_ADDR_BUS_A7        PIO_PC5_IDX
#define PIN_EBI_ADDR_BUS_A8        PIO_PC6_IDX
#define PIN_EBI_ADDR_BUS_A9        PIO_PC7_IDX
#define PIN_EBI_ADDR_BUS_A10       PIO_PC8_IDX
#define PIN_EBI_ADDR_BUS_A11       PIO_PC9_IDX
#define PIN_EBI_ADDR_BUS_A12       PIO_PC10_IDX
#define PIN_EBI_ADDR_BUS_A13       PIO_PC11_IDX
#define PIN_EBI_ADDR_BUS_A14       PIO_PC20_IDX
#define PIN_EBI_ADDR_BUS_A15       PIO_PC21_IDX
#define PIN_EBI_ADDR_BUS_A16       PIO_PC22_IDX
#define PIN_EBI_ADDR_BUS_A17       PIO_PC23_IDX
#define PIN_EBI_ADDR_BUS_A18       PIO_PC24_IDX
#define PIN_EBI_ADDR_BUS_A19       PIO_PC25_IDX
#define PIN_EBI_ADDR_BUS_A20       PIO_PC26_IDX
#define PIN_EBI_ADDR_BUS_A21       PIO_PB21_IDX


/** EBI NRD pin */
#define PIN_EBI_NRD                 PIO_PB19_IDX
#define PIN_EBI_NRD_FLAGS       PIO_PERIPH_A | PIO_PULLUP
#define PIN_EBI_NRD_MASK  1 << 19
#define PIN_EBI_NRD_PIO  PIOB
#define PIN_EBI_NRD_ID  ID_PIOB
#define PIN_EBI_NRD_TYPE PIO_PERIPH_A
#define PIN_EBI_NRD_ATTR PIO_PULLUP
/** EBI NWE pin */
#define PIN_EBI_NWE                  PIO_PB23_IDX
#define PIN_EBI_NWE_FLAGS       PIO_PERIPH_A | PIO_PULLUP
#define PIN_EBI_NWE_MASK  1 << 23
#define PIN_EBI_NWE_PIO  PIOB
#define PIN_EBI_NWE_ID  ID_PIOB
#define PIN_EBI_NWE_TYPE PIO_PERIPH_A
#define PIN_EBI_NWE_ATTR PIO_PULLUP
/** EBI NCS0 pin */
#define PIN_EBI_NCS0                PIO_PB20_IDX
#define PIN_EBI_NCS0_FLAGS     PIO_PERIPH_A | PIO_PULLUP
#define PIN_EBI_NCS0_MASK  1 << 20
#define PIN_EBI_NCS0_PIO  PIOB
#define PIN_EBI_NCS0_ID  ID_PIOB
#define PIN_EBI_NCS0_TYPE PIO_PERIPH_A
#define PIN_EBI_NCS0_ATTR PIO_PULLUP

//! LED #0 pin definition
#define LED_0_NAME    "green LEDHB"
#define LED0_GPIO     (PIO_PA29_IDX)
#define LED0_FLAGS    (PIO_TYPE_PIO_OUTPUT_1 | PIO_DEFAULT)
#define LED0_ACTIVE_LEVEL 1

//! LED #1 pin definition
#define LED_1_NAME    "red TX"
#define LED1_GPIO     (PIO_PA31_IDX)
#define LED1_FLAGS    (PIO_TYPE_PIO_OUTPUT_1 | PIO_DEFAULT)
#define LED1_ACTIVE_LEVEL 1

//! LED #1 pin definition
#define LED_2_NAME    "red RX"
#define LED2_GPIO     (PIO_PC12_IDX)
#define LED2_FLAGS    (PIO_TYPE_PIO_OUTPUT_1 | PIO_DEFAULT)
#define LED2_ACTIVE_LEVEL 1

#define BOARD_NUM_OF_LED 3

//! General Pins
#define PIN_PWRON_GPIO	  PIO_PC19_IDX
#define PIN_PWRON_FLAGS  (PIO_TYPE_PIO_OUTPUT_0 | PIO_DEFAULT) 
#define board_sram_pwron() gpio_set_pin_low(PIN_PWRON_GPIO)
#define board_sram_pwroff() gpio_set_pin_high(PIN_PWRON_GPIO)

	
/** Base address of PSRAM */
#define BOARD_PSRAM_ADDR         (0x60000000)

#define CONSOLE_UART               UART
#define CONSOLE_UART_ID            ID_UART

/** Address for transferring data bytes to the nandflash. */
#define BOARD_NF_DATA_ADDR      0x61000000

#endif  // _SAM3U_EK_H_
