newaetech/phywhispererusb/(commit log)

2019-03-29 Add initial hardware files
    [ct_back.SchDoc, ct_fpga_io.SchDoc, ct_fpga_pwr.SchDoc, ct_frontend.SchDoc, ct_micro.SchDoc, ct_psu.SchDoc, ct_userio.SchDoc, cwtrigger_usb.PrjPcb]
2019-05-28 Update schematic with latest version
2019-05-28 Add Rev-02 PCB data
    [altium_fpga_pins.csv, ct_frontend.SchDoc, ct_micro.SchDoc, ct_psu.SchDoc, cwtrigger_usb.PrjPcb]
2019-05-29 Add firmware/python script to program bitstream
    [Makefile.hal]
2019-05-30 Renamed CW521* to phywhisperer
    [Makefile.hal]
2019-05-30 Added firmware->.py generation and loading
    [Makefile.hal]
2019-06-01 Update PCB with more small fixes - silkscreen, move trace between pads to make it clear there is no short on QFN
    [ct_fpga_io.SchDoc, ct_fpga_pwr.SchDoc, ct_frontend.SchDoc, ct_micro.SchDoc, ct_psu.SchDoc, cwtrigger_usb.PrjPcb, fpga_misc.SchDoc]
2019-07-05 Fix issue with sam3u being unresponsive after bulk read
    [usb.c]
2019-07-08 Update altium hardware design files
    [cwtrigger_usb.PrjPcb]
2019-07-23 Use USB_SPARE0 to drive FPGA reset pin.
2019-07-24 Update PCB design files for -03 rev.
    [ct_back.SchDoc, ct_frontend.SchDoc, ct_micro.SchDoc, ct_userio.SchDoc, fpga_misc.SchDoc]
2019-07-30 Fixed timestamping; enable timestamping by default.
    [fe_capture.v, phywhisperer_top.v]
2019-08-05 Added pattern matcher module.
    Verified for patterns and masks up to 8 bytes.
    Support capture upon pattern match, of a programmable number of events.
    Currently the matching pattern is NOT captured in the capture FIFO.
    Testbench generates two arm-match-capture events, to verify that the
    DUT returns to a proper state after the first series of events.
    Wired the Armed and Capturing LEDs.
2019-08-06 Better test re-arming.
    Added a global timeout.
    Renamed testbench variables to make easier to follow.
    Re-arming still tends to fail but it should get fixed by flushing the
    capture FIFO upon arming (not implemented yet).
    [regress.py, tb_pw.v]
2019-08-06 Fix pattern match bug:
    Corner case where a capture event occurs on the very next clock cycle
    after a pattern match.
    [pw_pattern_matcher.v]
2019-08-08 Trigger updates.
    RTL: fix re-arming; added ILA.
    testbench: add full verification of the trigger delay and width.
    Jupyter: added simple notebook showing how to program the trigger.
    [phywhisperer_top.v, pw_pattern_matcher.v, regress.py, tb_pw.v]
2019-08-13 Minor RTL tweaks.
    - tweaked and clarified capture start and stop conditions
    - fixed FIFO status signals
    - added mcx_trig output
    [defines.v, fe_capture.v, phywhisperer.xdc, phywhisperer_top.v, pw_pattern_matcher.v]
2019-08-15 Regression testsuite improvements:
    - add short_trigger testcase (ensures CDC on trigger -> pattern match works);
    - add ability to regress a subset of testcases via testname pattern matching
    [regress.py]
2019-08-16 Handle clock domain crossings properly.
    Fixed at least one real bug (short pulse in trigger_clk domain missed in
    slower fe_clk domain).
    Timing is now clean, except for missing I/O delays.
    Didn't use Xilinx XPM primitives because iverilog doesn't like them.
    [fe_capture.v, phywhisperer_top.v, pw_pattern_matcher.v, tb_pw.v]
2019-08-19 Testbench improvements.
    - randomize pattern mask
    - ensure pre-trigger data doesn't accidentally generate a pattern match,
    which allows proper testing of single-byte patterns
    [regress.py, tb_pw.v]
2019-08-22 Add missing Vivado debug probes file.
2019-08-22 Minor HW and SW updates:
    - ability to read 'arm' status (useful for triggering in a tight loop)
    - added "blocking" mode to read_from_fifo() which checks whether the
    capture FIFO has data before every read, which allows the read to be
    kicked off whether or not data is available yet
2019-08-29 Stream mode support.
    Idea is simple (if reading empty FIFO, return a special code and don't
    increment read count), but lots of changes and bugfixes to get this working.
    One notable bug: depending on FIFO write timing, could previously have
    missed overflow condition.
    At the SW level, the stream read is still done using the same cmdReadMem
    commmand that regular reads use; that can be improved, so this is more
    a proof of concept.
    [defines.v, phywhisperer_top.v, regress.py, tb_pw.v]
2019-09-01 Testbench re-organization to make it more readable.
    Mostly moving things into tasks. Fixed a couple of possible bugs along
    the way.
    [regress.py, tb_pw.v]
2019-09-04 Testbench bug fix.
    Ensure USB status flags change when expecting it to count as a 'USB
    event'.
    [tb_pw.v]
2019-09-04 Fixed some FPGA implementation warnings.
    [phywhisperer_top.v, usb_autodetect.v]
2019-09-06 Fix stream read debug.
    For the case where empty FIFO reads occur.
    Add a testcase to cover this situation.
    Adjust regression test frequencies to rein in the regression time.
    [regress.py]
2019-10-15 Fix USB speed autodetect for Mac hosts.
    When a FS target is connected to a Mac host, it takes a bit longer for
    the linestate0/1 lines to begin toggling; adjusted autodetect parameters
    to account for this.
    Made autodetect parameters programmable so that future tweaks won't
    require a bitfile update.
    Current autodetect parameters have been verified with a handful of USB
    target devices on the following hosts:
    - Windows 10
    - Ubuntu 18.10 in VirtualBox 6.0.4 on a Win10 host, with all 3 USB
    controller settings
    - MacOS 10.11.6 on 2009 Mac Mini
    - MacOS 10.13.16 on 2015 MBP
    - MacOS 10.14.6 on 2016 MB
    [defines.v, phywhisperer_top.v, tb_usb_autodetect.v, usb_autodetect.v]
2019-11-11 Update PhyWhisperer-USB firmware for actual PID/VID
2019-11-11 Update PCB for Rev04A
    [ct_back.SchDoc, ct_fpga_io.SchDoc, ct_frontend.SchDoc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]
2019-11-11 Fix PID=C610 now (correct PID)
    [conf_usb.h]
2019-11-11 Beef up pattern matcher.
    Previous implementation only compared the incoming byte, and so for
    patterns longer than 1 byte, a near-match could cause us to miss an
    actual match (very unlikely, very specific pattern and input needed to
    trigger this). Now the full pattern is compared, no ifs or buts.
    There are two changes under the hood, to simplify the hardware, which
    are hidden by the API:
    1. the mask and pattern are now programmed in reverse byte order
    2. the mask is extended to the full 64-byte width (with zeros)
    [defines.v, pw_pattern_matcher.v, regress.py, tb_pw.v]
2019-11-11 Add drivers (signed), update PID in Python
2019-11-12 Update schematic files to use correct template, update PDF
    [ct_back.SchDoc, ct_fpga_io.SchDoc, ct_fpga_pwr.SchDoc, ct_frontend.SchDoc, ct_micro.SchDoc, ct_psu.SchDoc, ct_userio.SchDoc, fpga_misc.SchDoc]
2019-11-12 2.7 support broken currently.. mark as such
2019-11-28 Log missing USB status flag changes.
    Previously, USB status flag changes in a DATA command weren't logged by
    split_data().
    [defines.v]
2019-11-28 SW improvements.
    - added print_packets() and print_flags() helper methods
    - log USB flags when using print_packets()
    - expanded sniff.ipynb notebook to show how to get more granular time
    information and to show how USB flags would present themselves
    - added more method documentation
2019-12-05 Fix pattern matcher HW bug.
    Was likely introduced when the pattern matcher was re-worked in
    4e9da7311db1aa8a1011bbd37f14627aa326c6e3. A false-positive match could
    occur by matching data bytes that were received prior to arming.
    [pw_pattern_matcher.v]
2020-07-09 Working bitfile.
    Lots of small FPGA and Python updates. Shifted the block addressing down
    to avoid using address[7] since it appears unconnected. Added missing
    usb speed autodetect logic. Updated ILAs.
    [defines_usb.v, phywhisperer.xdc, phywhisperer_top.v, reg_usb.v, tb_pw.v]
2020-07-15 FPGA: Move arm logic to the main register block.
    Turns out it makes sense for all frontends to share this.
2020-07-20 FPGA: new option to start timer right away.
    To accomodate other front-ends.
2020-07-27 FPGA: cleanup, update ILAs, adjust read timing.
    Provide read data one cycle earlier to gain extra margin due to unstable
    reads on the CW305 platform. This required FIFO reads to change so that
    the first byte of every 4-byte read contains dummy data, instead of the
    last byte.
    Also fixed a bug introduced while refactoring, where an overflow event
    may be missed, resulting in some FIFO writes of USB events to be missed.
    To be clear, this bug was *not* present on the main branch.
    [fe_capture_usb.v, phywhisperer_top.v, reg_usb.v, regress.py, tb_pw.v]
2020-09-08 Fixed USB_Addr[6:7] lines.
    Unused in the original PhyWhisperer-USB release; needed in order to add
    more frontends.
    [phywhisperer.xdc]
2020-09-15 Parameterized COUNTER_QUICK_START reset value.
    PW-USB and PW-trace need a different default setting for this register;
    parameterizing the register default avoids needing to set it explicitly.
2020-09-21 Add board rev register.
    Allows for different FPGA D0-7 pin mappings, which changed from rev-03
    to rev-04 board.
2020-09-22 FPGA: extend addressing range by one bit.
    Address space of trace block was fully utilized; each register block now
    has 6 bits of address space, lots of room to grow now.
2020-10-05 RTL typo fix.
    Harmless now but could've caused hours of debug confusion later!
    [reg_usb.v]
2020-10-27 Move USERIO registers from USB to main.
    Makes sense for the TraceWhisperer use case.
2020-10-27 Parameterize USERIO width (for TraceWhisperer).
2020-11-09 Add link to TraceWhisperer.
2020-11-16 FPGA: add "capture now" feature.
    For when you don't want to use a pattern match or a trigger pin.
2020-11-17 FPGA: add arm pulse signal.
    Used by TraceWhisperer to automatically re-sync when arming; unused by
    PW-USB.
2020-12-13 FPGA: free up the USB_SPARE0,1 lines.
    FPGA reset is now done via a register write.
    ALE isn't really needed after all. The only scenario impacted by this
    change is if you wanted to repeatedly read or write the first byte of a
    multi-byte register; you can't do that anymore. Now, the byte offset
    gets reset to 0 only when a new address (different from the previous
    one) is seen.
    The objective of these changes is that the USB_SPARE* lines will be
    available to enable a new faster FIFO read mode.
    [phywhisperer_top.v]
2020-12-15 FPGA: finalize fast FIFO read mechanism.
    Read data is now set up *prior* to the active read pulse, for minimal
    latency.
    To enable this, the data bus is held driven in fast FIFO read mode until
    USB_nCS goes back high. Care must be taken to avoid contention on the
    data bus: if you need to intersperse FPGA writes, make sure USB_nCS goes
    high first.
    [phywhisperer_top.v]
2020-12-15 FPGA: moved REG_TIMESTAMPS_DISABLE to reg_main.v
    For use by tracewhisperer. Tested by tracewhisperer testbench but not by
    PW-USB testbench! Not intended for use by PW-USB.
2020-12-16 changes that were missing in previous commit
    [defines_usb.v]
2021-01-05 FPGA: new feature, capture while trigger is high.
    Intended for TraceWhisperer.
2021-01-08 FPGA: Fix timestamp counter overflow bug.
    See: https://github.com/newaetech/phywhispererusb/issues/9
    Unlikely to occur with PhyWhisperer-USB; more of a TraceWhisperer (which
    which shares PW-USB's Verilog) bug.
    The fix includes an off-by-one change in how timestamps are reported
    (see usb.py changes).
    New testcases have been added to cover the conditions which allowed the
    bug to be undetected until now.
    [fifo_generator_0_sim_netlist.v, phywhisperer_top.v, regress.py, tb_pw.v]
2021-09-09 TraceWhisperer: allow for trace or target clock.
    When using trace clock, every tick equals 2 target clocks, so increment
    timestamp counter accordingly.
2021-09-13 Fix timestamping bug.
    Fixes https://github.com/newaetech/phywhispererusb/issues/12
    Would occur with consecutive events at the same time as, or just before,
    the maximum timestamp counter is reached.
    Discovered in TraceWhisperer development but also applies here.
    Augmented testing to catch this type of bug in case it pops up again.
    [regress.py, tb_pw.v, tb_usb_autodetect.v]
2021-09-14 TraceWhisperer tweak.
    Make max timestamp even when using trace clock (because time counter
    increments by 2).
2021-11-30 Add LED_SELECT register.
2021-12-03 Derive BOARD_REV from define.
    For TraceWhisperer... since this affects inputs that go to IDDRs, it
    must be compile-time. This should also avoid confusion around forgetting
    to set the board rev properly - since it's now done at compile time, it
    only needs to be done correctly once.
2021-12-03 Fix possible multi-byte register access issue.
    Because there is no ALE, back-to-back access to the same multi-byte
    register may not behave as intended do to reg_bytecnt not starting at 0
    on subsequent accesses. Fixed for most registers except for those whose
    number of bytes is not a power of 2.
2021-12-15 Update FPGA bitfile.
    No actual changes - just wanted to make sure that the Vivado project
    runs correctly.
    [fifo_generator_0_sim_netlist.v]
2022-02-15 phywhisperer-common update.
    No functional changes for PW-USB. Updates to accomodate adding
    TraceWhisperer to Husky, which shares Verilog code with phywhisperer.
2022-05-11 Rebuilt bitfile.
    Under-the-hood changes to shared code with TraceWhisperer.
    Fix empty_fifo_read clear condition.
2022-05-11 Add missing unused ports.
    [phywhisperer_top.v]
2023-05-11 WIP: allow repeated pattern match triggers...
    ...without re-arming.
    Use set_num_pm_triggers(X) and up to X triggers will be issued.
    Seems to work, not properly tested yet.
    [defines_usb.v, pattern_matcher_usb.v, phywhisperer_top.v, reg_usb.v]
2024-03-21 Streamline driver installation instructions.
